evaneidt/Camera-Dev/README.md

# Camera-Dev
Repo for camera dev board schematics, CAD, and code.
