evaneidt/Camera-Dev/Drawings/I2S Clock Diagram.png

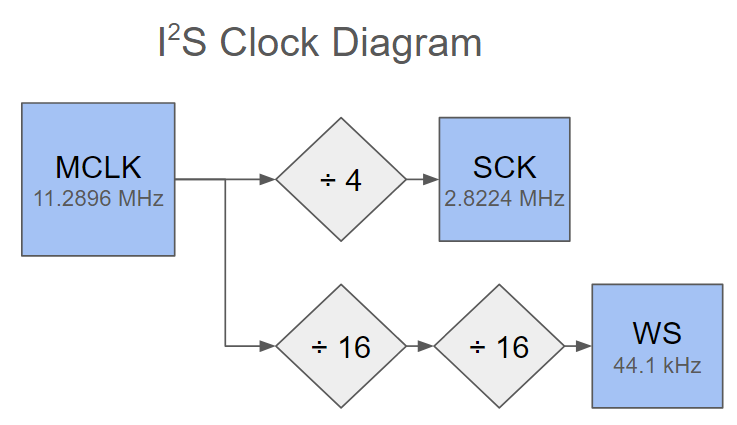
Drawings/I2S Clock Diagram.png
