evaneidt/Camera-Dev/Sims/Draft1.asc

C1: cap; 1000p
C2: cap; 3900p
C3: cap; 10µ
R1: res; 5.1k
R2: res; 2.2k
R3: res; 4.7k
R4: res; 1000
U1: opamp
V1: voltage; 2.5
V2: voltage; ""; AC 1.95
Named nets: 0, OUT, FB, IN
.ac dec 100 0.1 100k
.lib opamp.sub
