evaneidt/Camera-Dev/Sims/PoR.asc

A1: diffschmitt
C1: cap; 1µ
R1: res; 100k
R2: res; 5k
R3: res; 10k
V1: voltage; PULSE(0 3.3 100m 1n 0 10)
Named nets: 0, Out, V1
.tran 1
