evaneidt/Camera-Dev/(list of files, drawings)

Other design files:
Schematics/Camera/freerouting.dsn
Schematics/Camera/temp-freerouting.dsn
