evaneidt/Camera-Dev/Schematics/Camera/Camera.kicad_pcb

## KiCad design Schematics/Camera/Camera.kicad_pcb (2024-11-17)

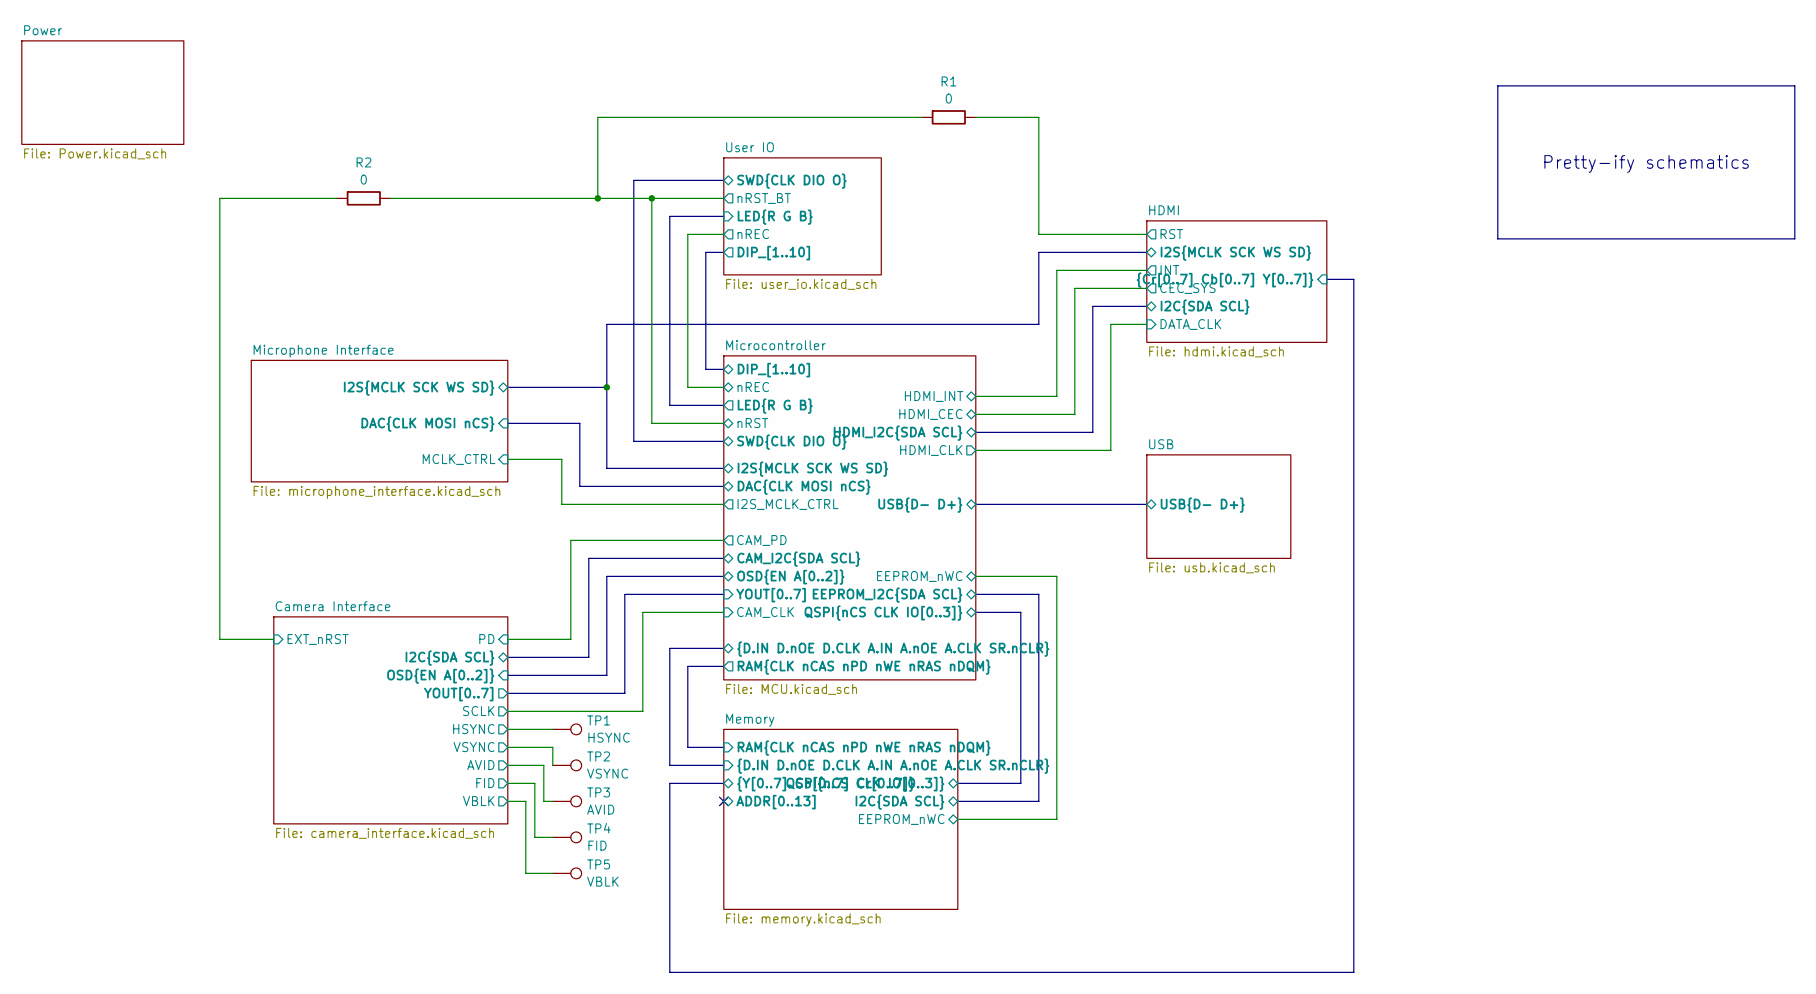
[picture p2: schematic Camera.kicad_sch, Camera Testing Board]

Parts:
R1, R2: 0; R_0603_1608Metric
TP1: HSYNC; TestPoint_Keystone_5000-5004_Miniature
TP2: VSYNC; TestPoint_Keystone_5000-5004_Miniature
TP3: AVID; TestPoint_Keystone_5000-5004_Miniature
TP4: FID; TestPoint_Keystone_5000-5004_Miniature
TP5: VBLK; TestPoint_Keystone_5000-5004_Miniature

Connections:
/Camera Interface/AVID: TP3.1; also elsewhere on the board
/Camera Interface/EXT_nRST: R2.1; also elsewhere on the board
/Camera Interface/FID: TP4.1; also elsewhere on the board
/Camera Interface/HSYNC: TP1.1; also elsewhere on the board
/Camera Interface/VBLK: TP5.1; also elsewhere on the board
/Camera Interface/VSYNC: TP2.1; also elsewhere on the board
/HDMI/RST: R1.2; also elsewhere on the board
/User IO/nRST_BT: R1.1, R2.2; also elsewhere on the board

Notes on the sheet:
Pretty-ify schematics

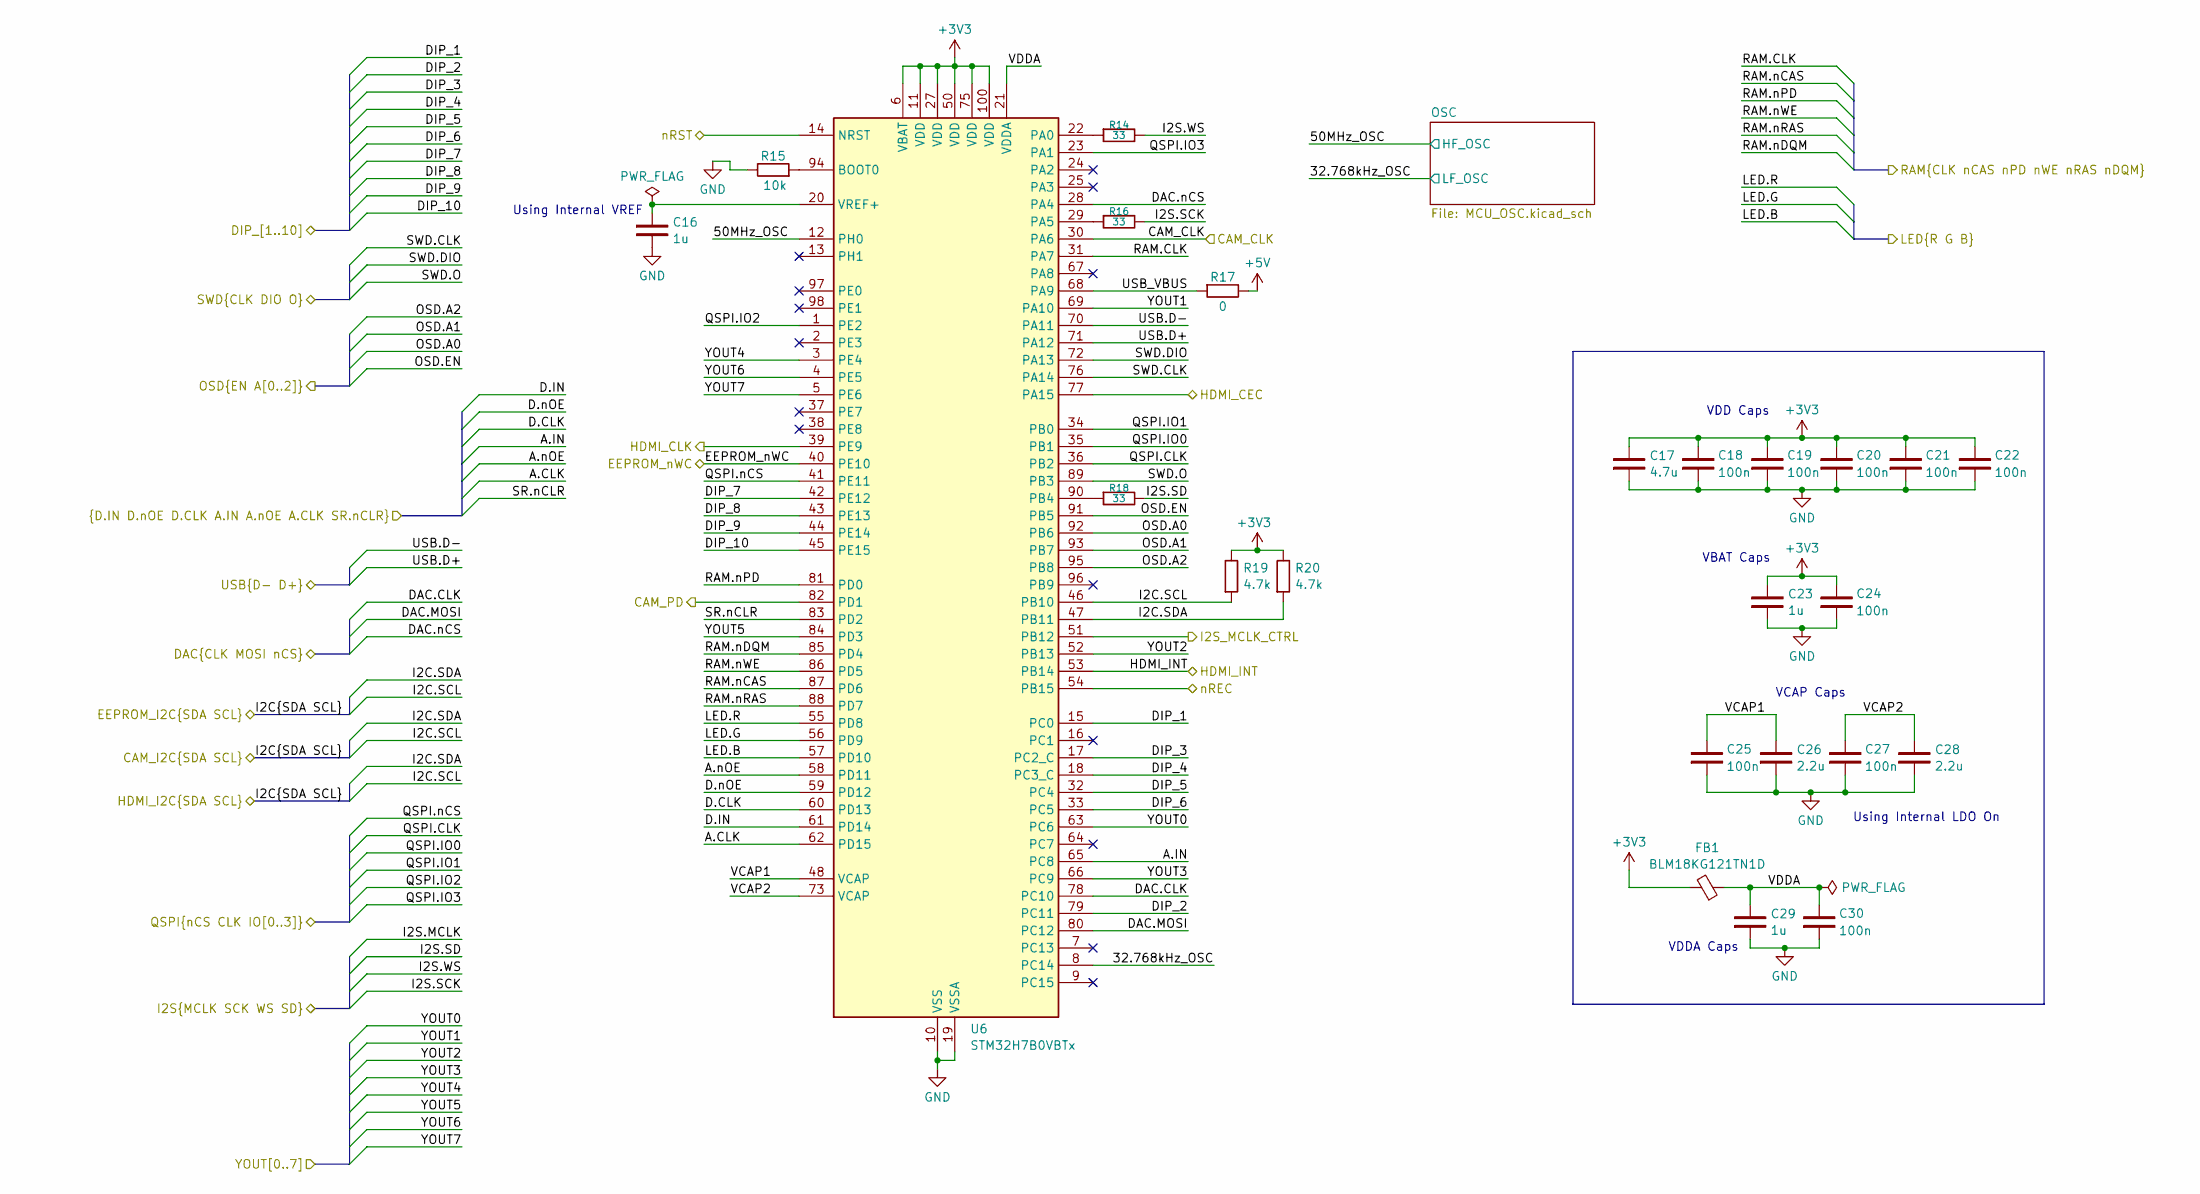
[picture p3: schematic MCU.kicad_sch, Camera Testing Board]

Parts:
C16, C23, C29: 1u; C_0603_1608Metric
C17: 4.7u; C_0603_1608Metric
C18, C19, C20, C21, C22, C24, C25, C27, C30: 100n; C_0603_1608Metric
C26, C28: 2.2u; C_0603_1608Metric
FB1: BLM18KG121TN1D; L_0603_1608Metric
R14, R16, R18: 33; R_0402_1005Metric
R15: 10k; R_0603_1608Metric
R17: 0; R_0603_1608Metric
R19, R20: 4.7k; R_0603_1608Metric
U6: STM32H7B0VBTx; LQFP-100_14x14mm_P0.5mm

Connections:
+3V3: C17.2, C18.2, C19.2, C20.2, C21.2, C22.2, C23.2, C24.2, FB1.2, R19.2, R20.2, U6.6 (VBAT), U6.11 (VDD), U6.27 (VDD), U6.50 (VDD), U6.75 (VDD), U6.100 (VDD); also elsewhere on the board
+5V: R17.2; also elsewhere on the board
/Camera Interface/OSD.A0: U6.92 (PB6); also elsewhere on the board
/Camera Interface/OSD.A1: U6.93 (PB7); also elsewhere on the board
/Camera Interface/OSD.A2: U6.95 (PB8); also elsewhere on the board
/Camera Interface/OSD.EN: U6.91 (PB5); also elsewhere on the board
/Camera Interface/PD: U6.82 (PD1); also elsewhere on the board
/Camera Interface/SCLK: U6.30 (PA6); also elsewhere on the board
/Camera Interface/YOUT0: U6.63 (PC6); also elsewhere on the board
/Camera Interface/YOUT1: U6.69 (PA10); also elsewhere on the board
/Camera Interface/YOUT2: U6.52 (PB13); also elsewhere on the board
/Camera Interface/YOUT3: U6.66 (PC9); also elsewhere on the board
/Camera Interface/YOUT4: U6.3 (PE4); also elsewhere on the board
/Camera Interface/YOUT5: U6.84 (PD3); also elsewhere on the board
/Camera Interface/YOUT6: U6.4 (PE5); also elsewhere on the board
/Camera Interface/YOUT7: U6.5 (PE6); also elsewhere on the board
/HDMI/CEC_SYS: U6.77 (PA15); also elsewhere on the board
/HDMI/DATA_CLK: U6.39 (PE9); also elsewhere on the board
/HDMI/I2C.SCL: R19.1, U6.46 (PB10); also elsewhere on the board
/HDMI/I2C.SDA: R20.1, U6.47 (PB11); also elsewhere on the board
/HDMI/I2S.SCK: R16.2; also elsewhere on the board
/HDMI/I2S.SD: R18.2; also elsewhere on the board
/HDMI/I2S.WS: R14.2; also elsewhere on the board
/HDMI/INT: U6.53 (PB14); also elsewhere on the board
/Memory/A.CLK: U6.62 (PD15); also elsewhere on the board
/Memory/A.IN: U6.65 (PC8); also elsewhere on the board
/Memory/A.nOE: U6.58 (PD11); also elsewhere on the board
/Memory/D.CLK: U6.60 (PD13); also elsewhere on the board
/Memory/D.IN: U6.61 (PD14); also elsewhere on the board
/Memory/D.nOE: U6.59 (PD12); also elsewhere on the board
/Memory/EEPROM_nWC: U6.40 (PE10); also elsewhere on the board
/Memory/QSPI.CLK: U6.36 (PB2); also elsewhere on the board
/Memory/QSPI.IO0: U6.35 (PB1); also elsewhere on the board
/Memory/QSPI.IO1: U6.34 (PB0); also elsewhere on the board
/Memory/QSPI.IO2: U6.1 (PE2); also elsewhere on the board
/Memory/QSPI.IO3: U6.23 (PA1); also elsewhere on the board
/Memory/QSPI.nCS: U6.41 (PE11); also elsewhere on the board
/Memory/RAM.CLK: U6.31 (PA7); also elsewhere on the board
/Memory/RAM.nCAS: U6.87 (PD6); also elsewhere on the board
/Memory/RAM.nDQM: U6.85 (PD4); also elsewhere on the board
/Memory/RAM.nPD: U6.81 (PD0); also elsewhere on the board
/Memory/RAM.nRAS: U6.88 (PD7); also elsewhere on the board
/Memory/RAM.nWE: U6.86 (PD5); also elsewhere on the board
/Memory/SR.nCLR: U6.83 (PD2); also elsewhere on the board
/Microcontroller/32.768kHz_OSC: U6.8 (PC14); also elsewhere on the board
/Microcontroller/50MHz_OSC: U6.12 (PH0); also elsewhere on the board
/Microcontroller/DAC.CLK: U6.78 (PC10); also elsewhere on the board
/Microcontroller/DAC.MOSI: U6.80 (PC12); also elsewhere on the board
/Microcontroller/DAC.nCS: U6.28 (PA4); also elsewhere on the board
/Microcontroller/DIP_1: U6.15 (PC0)
/Microcontroller/DIP_2: U6.79 (PC11)
/Microcontroller/DIP_3: U6.17 (PC2_C)
/Microcontroller/DIP_4: U6.18 (PC3_C)
/Microcontroller/DIP_5: U6.32 (PC4)
/Microcontroller/DIP_6: U6.33 (PC5)
/Microcontroller/DIP_7: U6.42 (PE12)
/Microcontroller/DIP_8: U6.43 (PE13)
/Microcontroller/DIP_9: U6.44 (PE14)
/Microcontroller/DIP_10: U6.45 (PE15)
/Microcontroller/LED.B: U6.57 (PD10); also elsewhere on the board
/Microcontroller/LED.G: U6.56 (PD9); also elsewhere on the board
/Microcontroller/LED.R: U6.55 (PD8); also elsewhere on the board
/Microcontroller/SWD.CLK: U6.76 (PA14); also elsewhere on the board
/Microcontroller/SWD.DIO: U6.72 (PA13); also elsewhere on the board
/Microcontroller/SWD.O: U6.89 (PB3); also elsewhere on the board
/Microcontroller/USB.D+: U6.71 (PA12); also elsewhere on the board
/Microcontroller/USB.D-: U6.70 (PA11); also elsewhere on the board
/Microcontroller/USB_VBUS: R17.1, U6.68 (PA9)
/Microcontroller/VCAP1: C25.2, C26.2, U6.48 (VCAP)
/Microcontroller/VCAP2: C27.2, C28.2, U6.73 (VCAP)
/Microcontroller/VDDA: C29.2, C30.2, FB1.1, U6.21 (VDDA)
/Microcontroller/nREC: U6.54 (PB15); also elsewhere on the board
/Microphone Interface/Microphone Clocks/CTRL: U6.51 (PB12); also elsewhere on the board
/User IO/nRST_BT: U6.14 (NRST); also elsewhere on the board
GND: C16.1, C17.1, C18.1, C19.1, C20.1, C21.1, C22.1, C23.1, C24.1, C25.1, C26.1, C27.1, C28.1, C29.1, C30.1, R15.2, U6.10 (VSS), U6.19 (VSSA), U6.26 (VSS), U6.49 (VSS), U6.74 (VSS), U6.99 (VSS); also elsewhere on the board
unnamed: R15.1, U6.94 (BOOT0)
unnamed: R14.1, U6.22 (PA0)
unnamed: R16.1, U6.29 (PA5)
unnamed: R18.1, U6.90 (PB4)
unnamed: C16.2, U6.20 (VREF+)

Notes on the sheet:
Using Internal LDO On
VDDA Caps
Using Internal VREF
VBAT Caps
VCAP Caps
VDD Caps

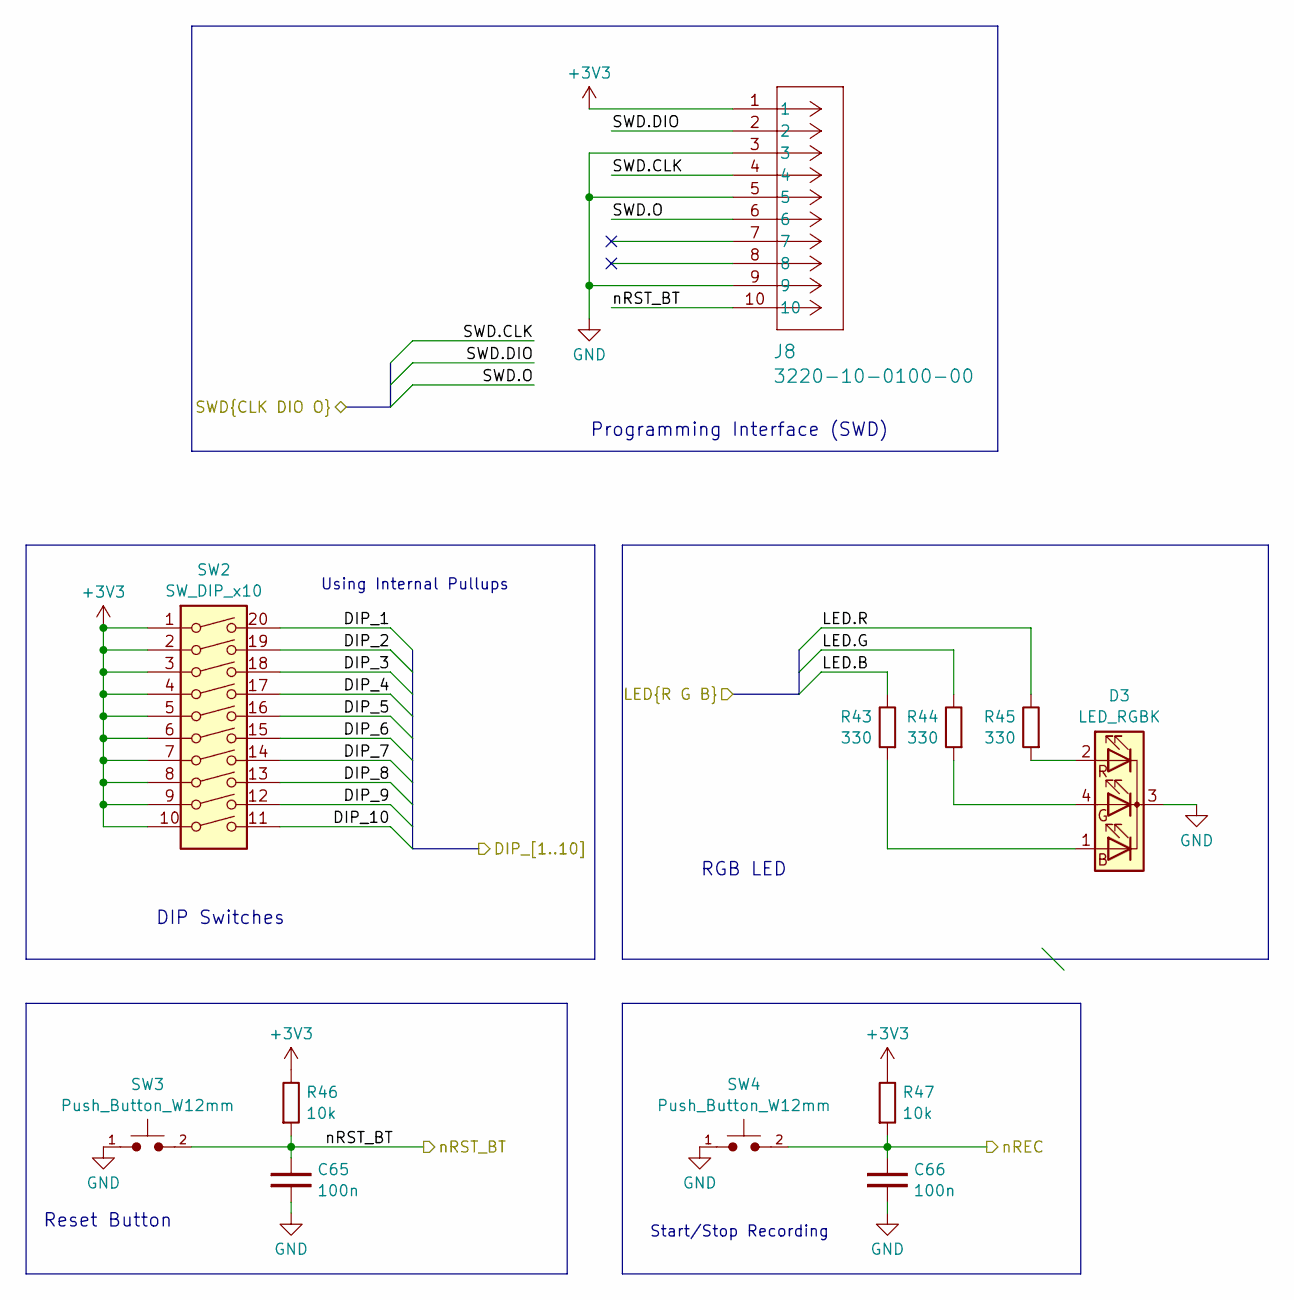
[picture p4: schematic user_io.kicad_sch, Camera Testing Board]

Parts:
C65, C66: 100n; C_0603_1608Metric
D3: LED_RGBK; LED_D5.0mm-4_RGB
J8: 3220-10-0100-00; CONN_3220-10-0100-00_CNC
R43, R44, R45: 330; R_0603_1608Metric
R46, R47: 10k; R_0603_1608Metric
SW2: SW_DIP_x10; DIP-20_W7.62mm
SW3, SW4: Push_Button_W12mm; SW_Push_1P1T_NO_CK_KSC7xxJ

Connections:
+3V3: J8.1, R46.2, R47.2, SW2.1, SW2.2, SW2.3, SW2.4, SW2.5, SW2.6, SW2.7, SW2.8, SW2.9, SW2.10; also elsewhere on the board
/Microcontroller/LED.B: R43.2; also elsewhere on the board
/Microcontroller/LED.G: R44.2; also elsewhere on the board
/Microcontroller/LED.R: R45.2; also elsewhere on the board
/Microcontroller/SWD.CLK: J8.4; also elsewhere on the board
/Microcontroller/SWD.DIO: J8.2; also elsewhere on the board
/Microcontroller/SWD.O: J8.6; also elsewhere on the board
/Microcontroller/nREC: C66.2, R47.1, SW4.2; also elsewhere on the board
/User IO/nRST_BT: C65.2, J8.10, R46.1, SW3.2; also elsewhere on the board
GND: C65.1, C66.1, D3.3 (K), J8.3, J8.5, J8.9, SW3.1, SW4.1; also elsewhere on the board
unnamed: D3.1 (BA), R43.1
unnamed: D3.4 (GA), R44.1
unnamed: D3.2 (RA), R45.1

Notes on the sheet:
Using Internal Pullups
DIP Switches
Programming Interface (SWD)
Start/Stop Recording
Reset Button
RGB LED

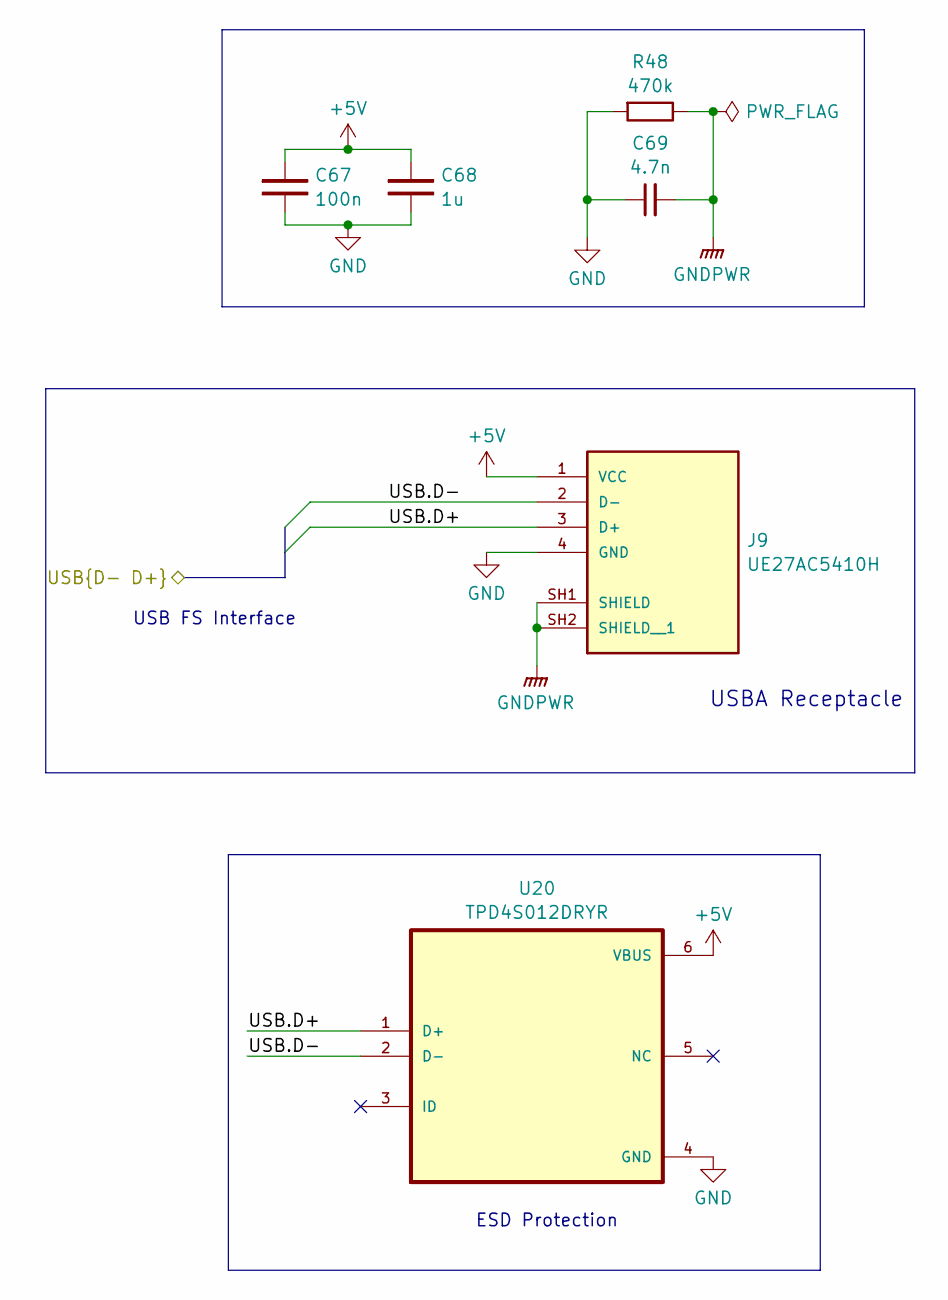
[picture p5: schematic usb.kicad_sch, Camera Testing Board]

Parts:
C67: 100n; C_0603_1608Metric
C68: 1u; C_0603_1608Metric
C69: 4.7n; C_0603_1608Metric
J9: UE27AC5410H; AMPHENOL_UE27AC5410H; PARTREV G
R48: 470k; R_0603_1608Metric
U20: TPD4S012DRYR; PSON50P145X100X60-6N

Connections:
+5V: C67.2, C68.2, J9.1 (VCC), U20.6 (VBUS); also elsewhere on the board
/Microcontroller/USB.D+: J9.3 (D+), U20.1 (D+); also elsewhere on the board
/Microcontroller/USB.D-: J9.2 (D-), U20.2 (D-); also elsewhere on the board
GND: C67.1, C68.1, C69.1, J9.4 (GND), R48.1, U20.4 (GND); also elsewhere on the board
GNDPWR: C69.2, J9.SH1 (SHIELD), J9.SH2 (SHIELD__1), R48.2; also elsewhere on the board

Notes on the sheet:
USB FS Interface
ESD Protection
USBA Receptacle

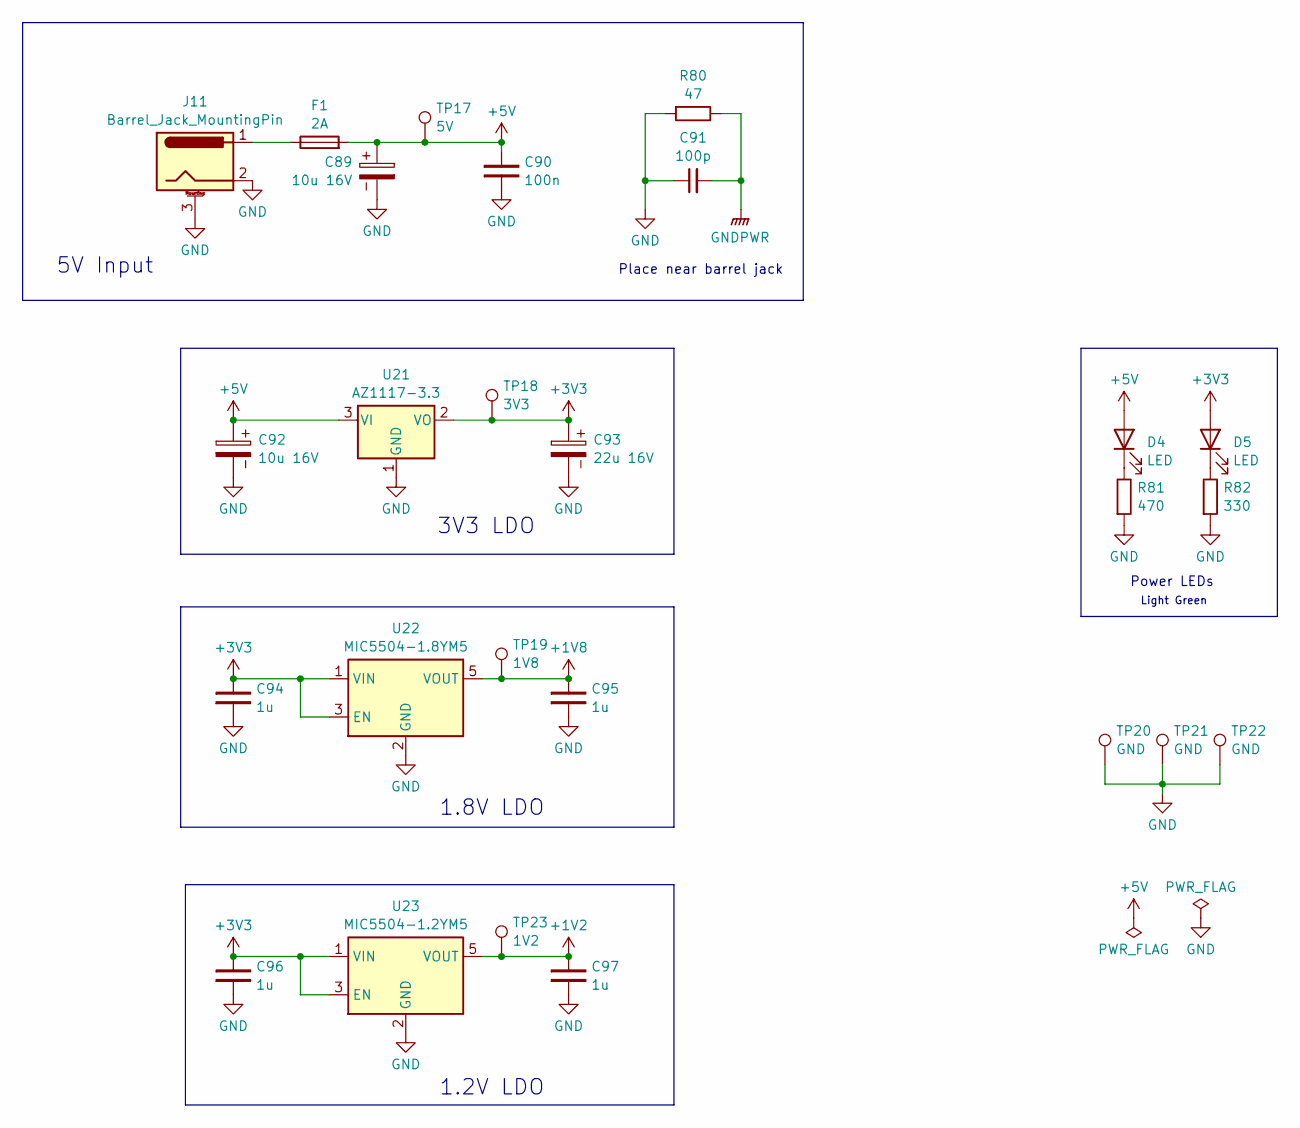
[picture p6: schematic Power.kicad_sch, Camera Testing Board]

Parts:
C89, C92: 10u 16V; CP_EIA-3216-18_Kemet-A
C90: 100n; C_0603_1608Metric
C91: 100p; C_0402_1005Metric
C93: 22u 16V; CP_EIA-3528-21_Kemet-B
C94, C95, C96, C97: 1u; C_0603_1608Metric
D4, D5: LED; LED_0603_1608Metric
F1: 2A; Fuse_0603_1608Metric_Pad1.05x0.95mm_HandSolder
J11: Barrel_Jack_MountingPin; BarrelJack_CUI_PJ-036AH-SMT_Horizontal
R80: 47; R_0603_1608Metric
R81: 470; R_0603_1608Metric
R82: 330; R_0603_1608Metric
TP17: 5V; TestPoint_Keystone_5000-5004_Miniature
TP18: 3V3; TestPoint_Keystone_5000-5004_Miniature
TP19: 1V8; TestPoint_Keystone_5000-5004_Miniature
TP20, TP21, TP22: GND; TestPoint_Keystone_5010-5014_Multipurpose
TP23: 1V2; TestPoint_Keystone_5000-5004_Miniature
U21: AZ1117-3.3; SOT-223-3_TabPin2
U22: MIC5504-1.8YM5; SOT-23-5
U23: MIC5504-1.2YM5; SOT-23-5

Connections:
+1V2: C97.2, TP23.1, U23.5 (VOUT); also elsewhere on the board
+1V8: C95.2, TP19.1, U22.5 (VOUT); also elsewhere on the board
+3V3: C93.1, C94.2, C96.2, D5.2 (A), TP18.1, U21.2 (VO), U22.1 (VIN), U22.3 (EN), U23.1 (VIN), U23.3 (EN); also elsewhere on the board
+5V: C89.1, C90.2, C92.1, D4.2 (A), F1.2, TP17.1, U21.3 (VI); also elsewhere on the board
GND: C89.2, C90.1, C91.1, C92.2, C93.2, C94.1, C95.1, C96.1, C97.1, J11.2, J11.3 (MountPin), R80.1, R81.1, R82.1, TP20.1, TP21.1, TP22.1, U21.1 (GND), U22.2 (GND), U23.2 (GND); also elsewhere on the board
GNDPWR: C91.2, R80.2; also elsewhere on the board
unnamed: D4.1 (K), R81.2
unnamed: D5.1 (K), R82.2
unnamed: F1.1, J11.1

Notes on the sheet:
Place near barrel jack
1.8V LDO
1.2V LDO
Power LEDs
3V3 LDO
Light Green
5V Input

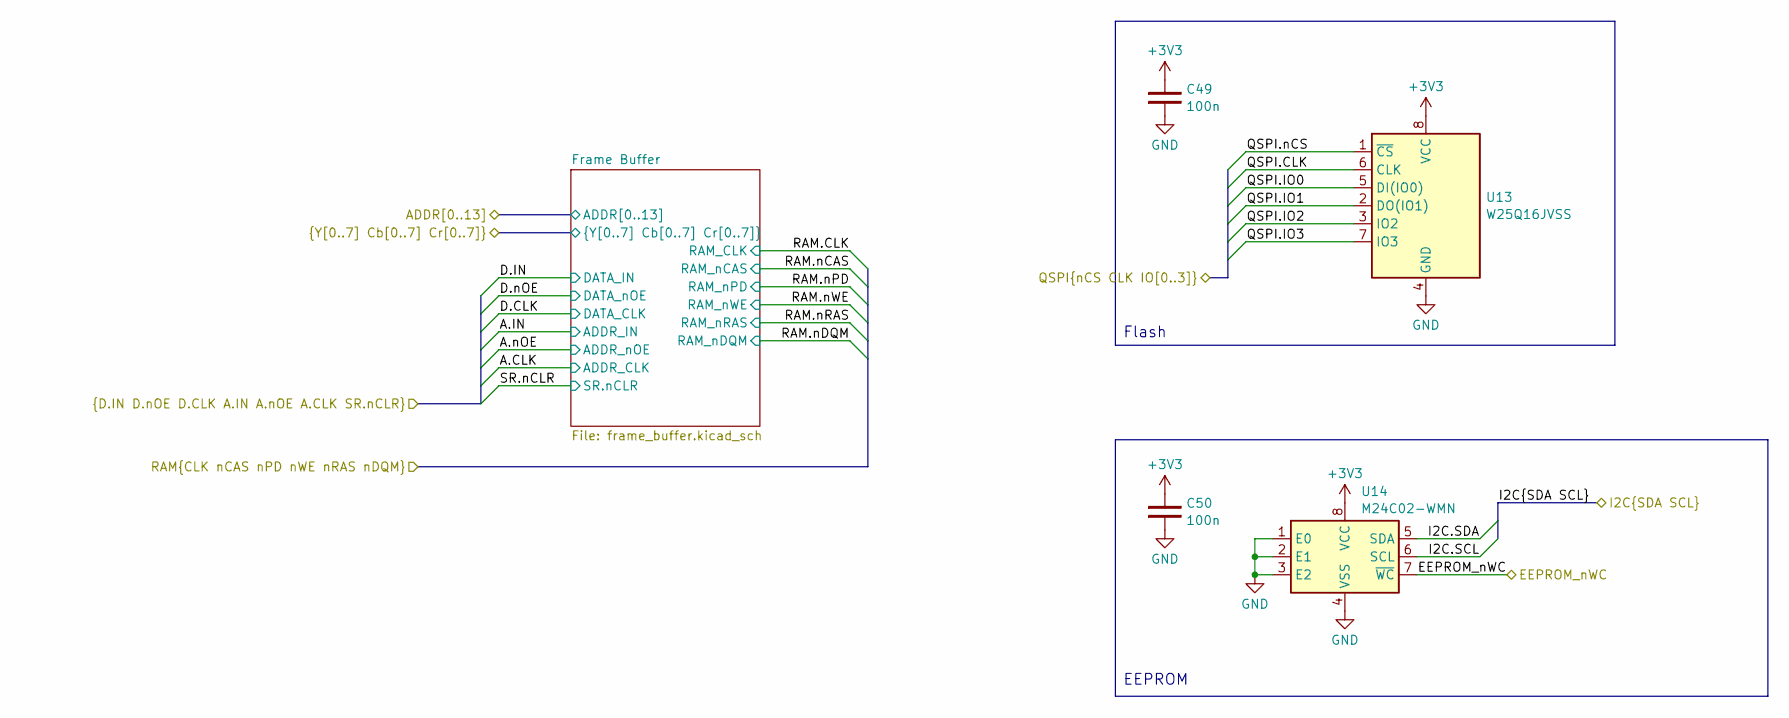
[picture p7: schematic memory.kicad_sch, Camera Testing Board]

Parts:
C49, C50: 100n; C_0603_1608Metric
U13: W25Q16JVSS; SOIC-8_5.23x5.23mm_P1.27mm
U14: M24C02-WMN; SOIC-8_3.9x4.9mm_P1.27mm

Connections:
+3V3: C49.2, C50.2, U13.8 (VCC), U14.8 (VCC); also elsewhere on the board
/HDMI/I2C.SCL: U14.6 (SCL); also elsewhere on the board
/HDMI/I2C.SDA: U14.5 (SDA); also elsewhere on the board
/Memory/EEPROM_nWC: U14.7 (~WC); also elsewhere on the board
/Memory/QSPI.CLK: U13.6 (CLK); also elsewhere on the board
/Memory/QSPI.IO0: U13.5 (DI(IO0)); also elsewhere on the board
/Memory/QSPI.IO1: U13.2 (DO(IO1)); also elsewhere on the board
/Memory/QSPI.IO2: U13.3 (IO2); also elsewhere on the board
/Memory/QSPI.IO3: U13.7 (IO3); also elsewhere on the board
/Memory/QSPI.nCS: U13.1 (~CS); also elsewhere on the board
GND: C49.1, C50.1, U13.4 (GND), U14.1 (E0), U14.2 (E1), U14.3 (E2), U14.4 (VSS); also elsewhere on the board

Notes on the sheet:
Flash
EEPROM

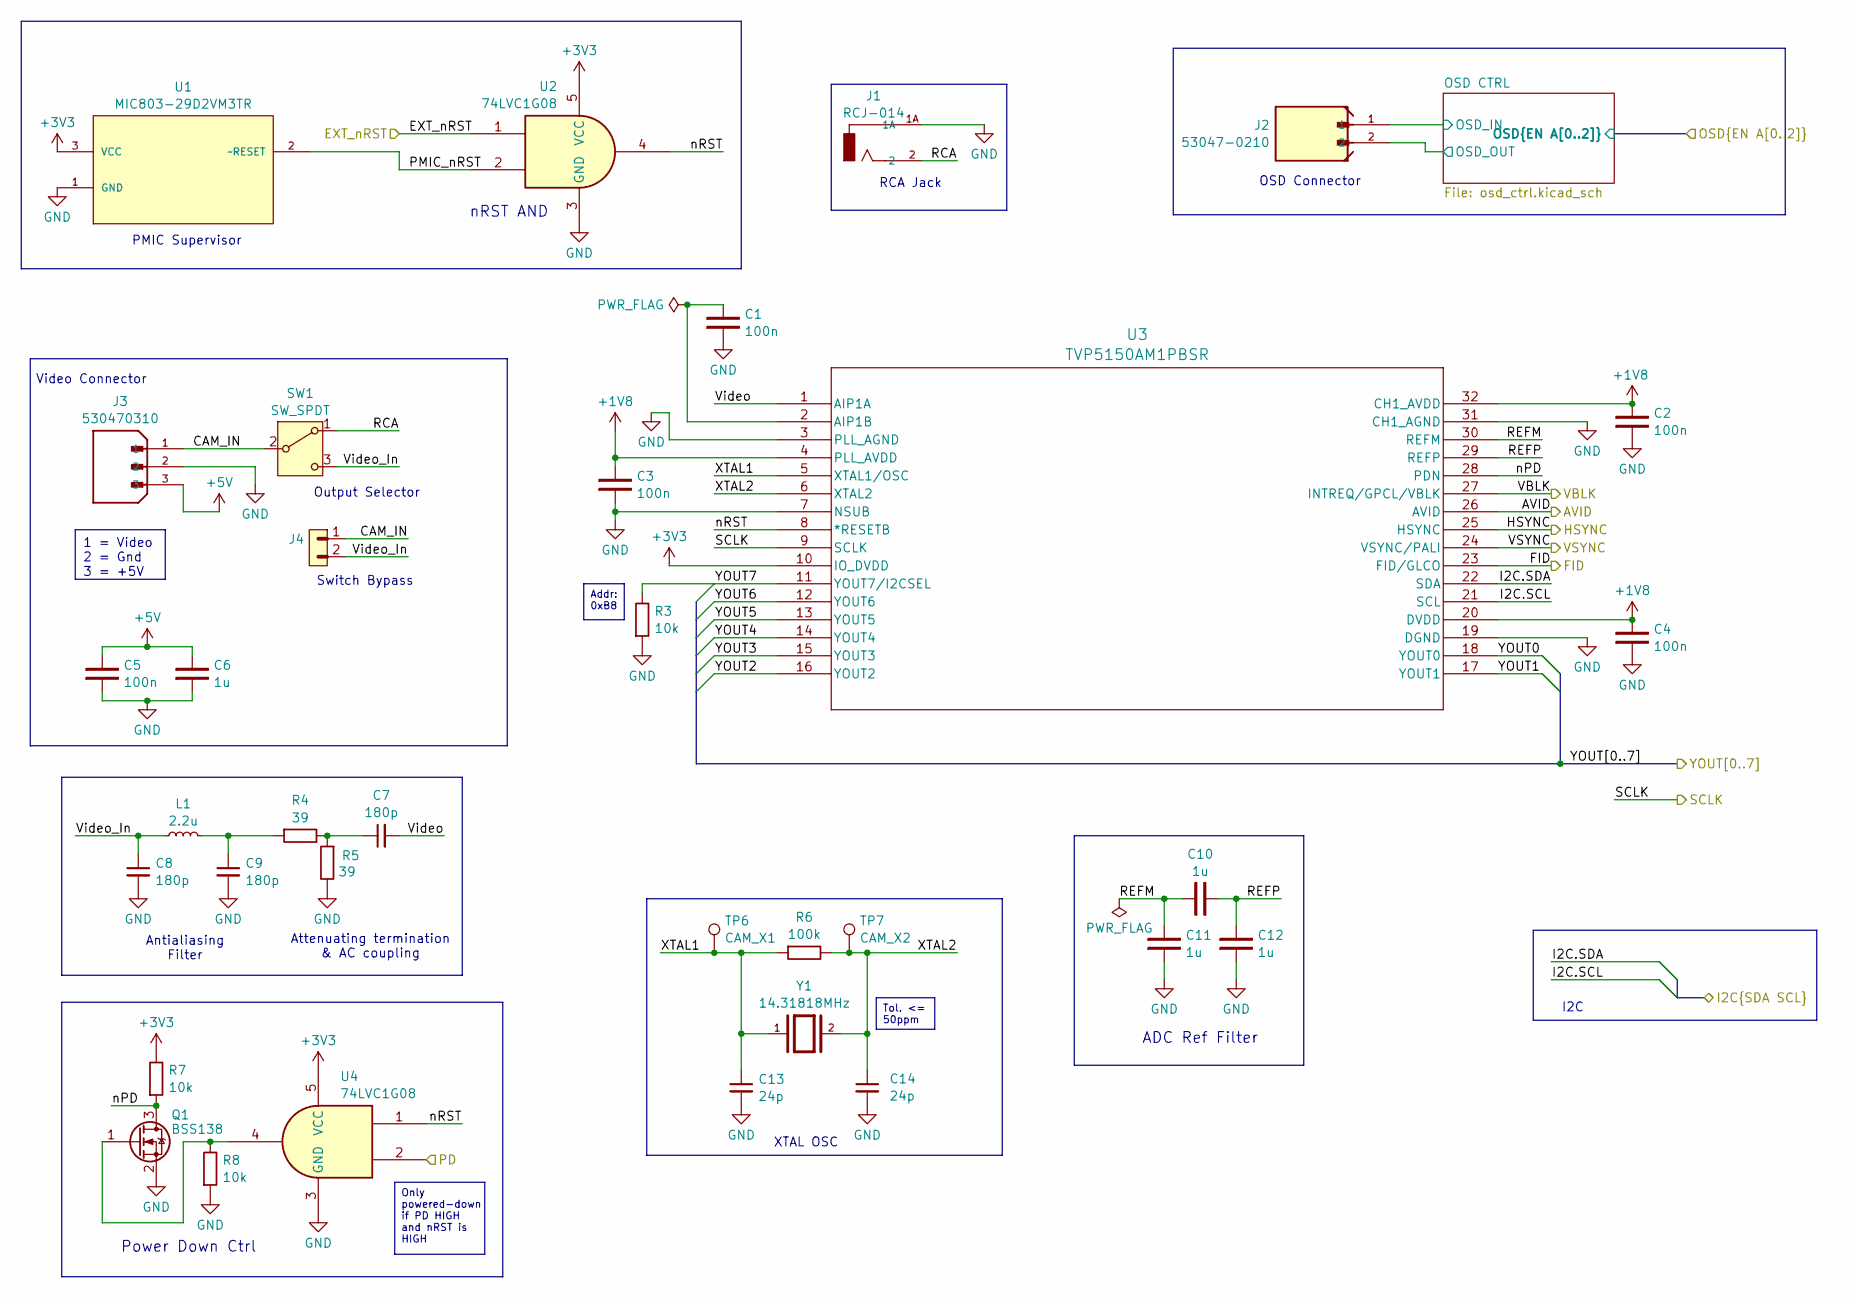
[picture p8: schematic camera_interface.kicad_sch, Camera Testing Board]

Parts:
C1, C2, C3, C4, C5: 100n; C_0603_1608Metric
C6, C10, C11, C12: 1u; C_0603_1608Metric
C7, C8, C9: 180p; C_0402_1005Metric
C13, C14: 24p; C_0402_1005Metric
J1: RCJ-014; CUI_RCJ-014; PART_REV B
J2: 53047-0210; Molex_PicoBlade_53047-0210_1x02_P1.25mm_Vertical; PARTREV 04/19/2022
J3: 530470310; MOLEX_530470310; PARTREV A
J4: PINHD_1x2_Male; PinHeader_1x02_P2.54mm_Vertical
L1: 2.2u; L_1008_2520Metric
Q1: BSS138; SOT-23
R3, R7, R8: 10k; R_0603_1608Metric
R4, R5: 39; R_0603_1608Metric
R6: 100k; R_0603_1608Metric
SW1: SW_SPDT; SW_Slide_SPDT_Straight_CK_OS102011MS2Q
TP6: CAM_X1; TestPoint_Keystone_5000-5004_Miniature
TP7: CAM_X2; TestPoint_Keystone_5000-5004_Miniature
U1: MIC803-29D2VM3TR; SOT95P232X110-3N; MPN MIC803-29D2VM3TR
U2, U4: 74LVC1G08; SOT-23-5
U3: TVP5150AM1PBSR; PBS32
Y1: 14.31818MHz; XTAL_ABLS2-14.31818MHZ-D4Y-T; PARTREV 11.15.2016

Connections:
+1V8: C2.2, C3.2, C4.2, U3.4 (PLL_AVDD), U3.20 (DVDD), U3.32 (CH1_AVDD); also elsewhere on the board
+3V3: R7.2, U1.3 (VCC), U2.5 (VCC), U3.10 (IO_DVDD), U4.5 (VCC); also elsewhere on the board
+5V: C5.2, C6.2, J3.3; also elsewhere on the board
/Camera Interface/AVID: U3.26 (AVID); also elsewhere on the board
/Camera Interface/CAM_IN: J3.1, J4.1, SW1.2 (B)
/Camera Interface/EXT_nRST: U2.1; also elsewhere on the board
/Camera Interface/FID: U3.23 (FID/GLCO); also elsewhere on the board
/Camera Interface/HSYNC: U3.25 (HSYNC); also elsewhere on the board
/Camera Interface/OSD CTRL/OSD_IN: J2.1; also elsewhere on the board
/Camera Interface/OSD CTRL/OSD_OUT: J2.2; also elsewhere on the board
/Camera Interface/PD: U4.2; also elsewhere on the board
/Camera Interface/PMIC_nRST: U1.2 (~RESET), U2.2
/Camera Interface/RCA: J1.2, SW1.1 (A)
/Camera Interface/REFM: C10.2, C11.2, U3.30 (REFM)
/Camera Interface/REFP: C10.1, C12.2, U3.29 (REFP)
/Camera Interface/SCLK: U3.9 (SCLK); also elsewhere on the board
/Camera Interface/VBLK: U3.27 (INTREQ/GPCL/VBLK); also elsewhere on the board
/Camera Interface/VSYNC: U3.24 (VSYNC/PALI); also elsewhere on the board
/Camera Interface/Video: C7.2, U3.1 (AIP1A)
/Camera Interface/Video_In: C8.1, J4.2, L1.1, SW1.3 (C)
/Camera Interface/XTAL1: C13.1, R6.1, TP6.1, U3.5 (XTAL1/OSC), Y1.1
/Camera Interface/XTAL2: C14.1, R6.2, TP7.1, U3.6 (XTAL2), Y1.2
/Camera Interface/YOUT0: U3.18 (YOUT0); also elsewhere on the board
/Camera Interface/YOUT1: U3.17 (YOUT1); also elsewhere on the board
/Camera Interface/YOUT2: U3.16 (YOUT2); also elsewhere on the board
/Camera Interface/YOUT3: U3.15 (YOUT3); also elsewhere on the board
/Camera Interface/YOUT4: U3.14 (YOUT4); also elsewhere on the board
/Camera Interface/YOUT5: U3.13 (YOUT5); also elsewhere on the board
/Camera Interface/YOUT6: U3.12 (YOUT6); also elsewhere on the board
/Camera Interface/YOUT7: R3.2, U3.11 (YOUT7/I2CSEL); also elsewhere on the board
/Camera Interface/nPD: Q1.3 (D), R7.1, U3.28 (PDN)
/Camera Interface/nRST: U2.4, U3.8 (*RESETB), U4.1
/HDMI/I2C.SCL: U3.21 (SCL); also elsewhere on the board
/HDMI/I2C.SDA: U3.22 (SDA); also elsewhere on the board
GND: C1.1, C2.1, C3.1, C4.1, C5.1, C6.1, C8.2, C9.2, C11.1, C12.1, C13.2, C14.2, J1.1A, J3.2, Q1.2 (S), R3.1, R5.2, R8.1, U1.1 (GND), U2.3 (GND), U3.3 (PLL_AGND), U3.7 (NSUB), U3.19 (DGND), U3.31 (CH1_AGND), U4.3 (GND); also elsewhere on the board
unnamed: C7.1, R4.2, R5.1
unnamed: C9.1, L1.2, R4.1
unnamed: Q1.1 (G), R8.2, U4.4
unnamed: C1.2, U3.2 (AIP1B)

Notes on the sheet:
Addr: 0xB8
Only powered-down if PD HIGH and nRST is HIGH
Tol. <= 50ppm
1 = Video 2 = Gnd 3 = +5V
I2C
Switch Bypass
PMIC Supervisor
Power Down Ctrl
Attenuating termination & AC coupling
XTAL OSC
OSD Connector
nRST AND
Video Connector
Antialiasing Filter
ADC Ref Filter
RCA Jack
Output Selector
