evaneidt/Camera-Dev/Schematics/Camera/Camera.kicad_pcb

## KiCad design Schematics/Camera/Camera.kicad_pcb (continued)

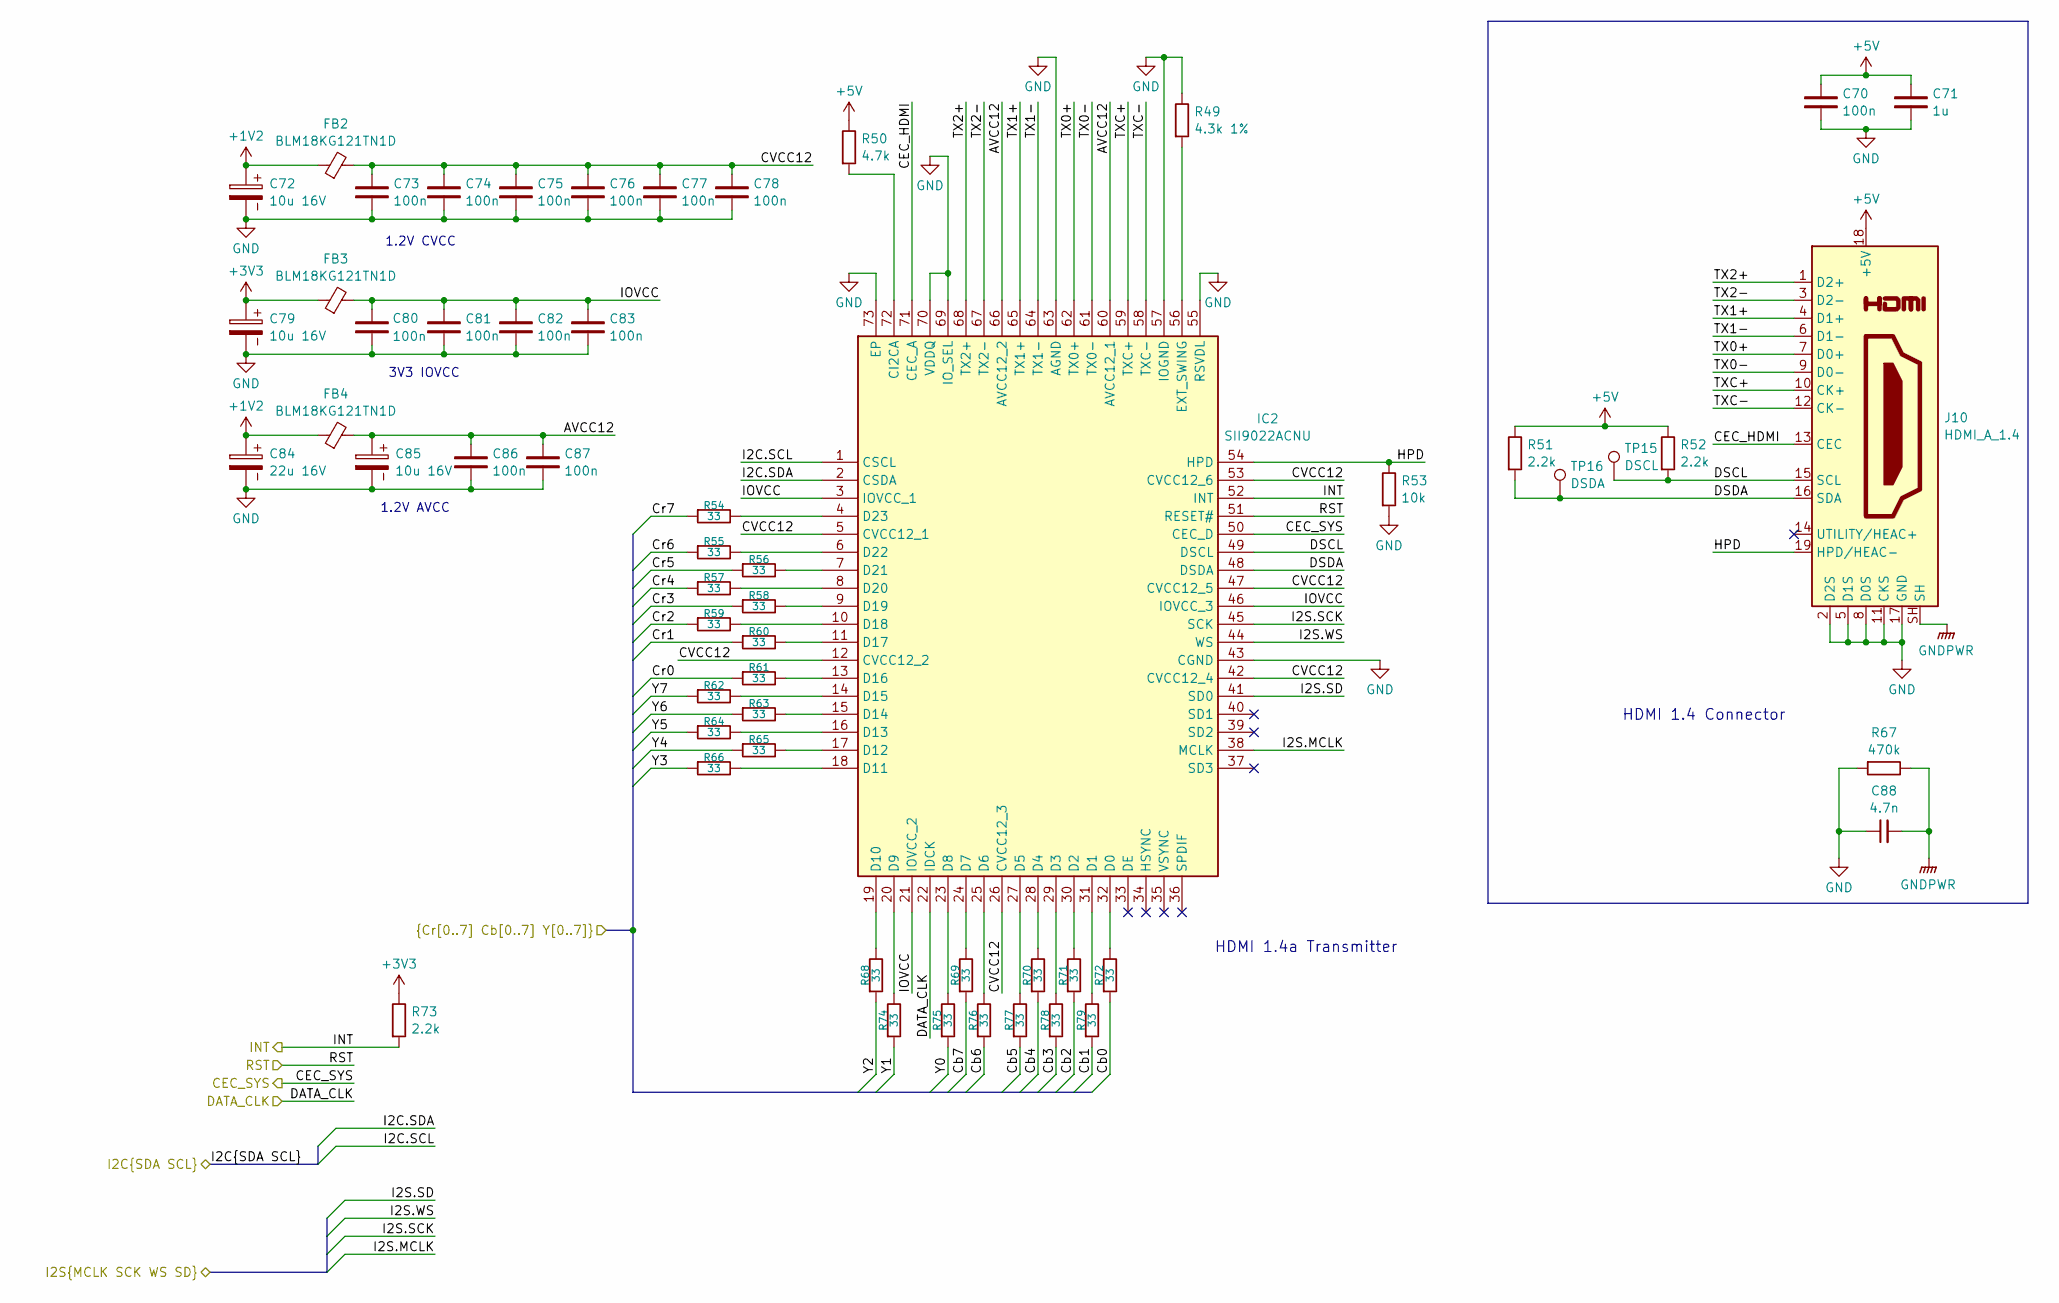
[picture p9: schematic hdmi.kicad_sch, Camera Testing Board]

Parts:
C70: 100n; C_0603_1608Metric
C71: 1u; C_0603_1608Metric
C72, C79, C85: 10u 16V; CP_EIA-3216-18_Kemet-A
C73, C74, C75, C76, C77, C78, C80, C81, C82, C83, C86, C87: 100n; C_0402_1005Metric
C84: 22u 16V; CP_EIA-3528-21_Kemet-B
C88: 4.7n; C_0603_1608Metric
FB2, FB3, FB4: BLM18KG121TN1D; L_0603_1608Metric
IC2: SII9022ACNU; QFN50P1000X1000X90-73N-D; Manufacturer_Part_Number SII9022ACNU
J10: HDMI_A_1.4; AMPHENOL_10029449-111RLF
R49: 4.3k 1%; R_0603_1608Metric
R50: 4.7k; R_0603_1608Metric
R51, R52, R73: 2.2k; R_0603_1608Metric
R53: 10k; R_0603_1608Metric
R54, R55, R56, R57, R58, R59, R60, R61, R62, R63, R64, R65, R66, R68, R69, R70, R71, R72, R74, R75, R76, R77, R78, R79: 33; R_0201_0603Metric
R67: 470k; R_0603_1608Metric
TP15: DSCL; TestPoint_Keystone_5000-5004_Miniature
TP16: DSDA; TestPoint_Keystone_5000-5004_Miniature

Connections:
+1V2: C72.1, C84.1, FB2.1, FB4.1; also elsewhere on the board
+3V3: C79.1, FB3.1, R73.2; also elsewhere on the board
+5V: C70.2, C71.2, J10.18 (+5V), R50.2, R51.2, R52.2; also elsewhere on the board
/HDMI/AVCC12: C85.1, C86.2, C87.2, FB4.2, IC2.60 (AVCC12_1), IC2.66 (AVCC12_2)
/HDMI/CEC_HDMI: IC2.71 (CEC_A), J10.13 (CEC)
/HDMI/CEC_SYS: IC2.50 (CEC_D); also elsewhere on the board
/HDMI/CVCC12: C73.2, C74.2, C75.2, C76.2, C77.2, C78.2, FB2.2, IC2.5 (CVCC12_1), IC2.12 (CVCC12_2), IC2.26 (CVCC12_3), IC2.42 (CVCC12_4), IC2.47 (CVCC12_5), IC2.53 (CVCC12_6)
/HDMI/Cb0: R72.1; also elsewhere on the board
/HDMI/Cb1: R79.1; also elsewhere on the board
/HDMI/Cb2: R71.1; also elsewhere on the board
/HDMI/Cb3: R78.1; also elsewhere on the board
/HDMI/Cb4: R70.1; also elsewhere on the board
/HDMI/Cb5: R77.1; also elsewhere on the board
/HDMI/Cb6: R76.1; also elsewhere on the board
/HDMI/Cb7: R69.1; also elsewhere on the board
/HDMI/Cr0: R61.1; also elsewhere on the board
/HDMI/Cr1: R60.1; also elsewhere on the board
/HDMI/Cr2: R59.1; also elsewhere on the board
/HDMI/Cr3: R58.1; also elsewhere on the board
/HDMI/Cr4: R57.1; also elsewhere on the board
/HDMI/Cr5: R56.1; also elsewhere on the board
/HDMI/Cr6: R55.1; also elsewhere on the board
/HDMI/Cr7: R54.1; also elsewhere on the board
/HDMI/DATA_CLK: IC2.22 (IDCK); also elsewhere on the board
/HDMI/DSCL: IC2.49 (DSCL), J10.15 (SCL), R52.1, TP15.1
/HDMI/DSDA: IC2.48 (DSDA), J10.16 (SDA), R51.1, TP16.1
/HDMI/HPD: IC2.54 (HPD), J10.19 (HPD/HEAC-), R53.2
/HDMI/I2C.SCL: IC2.1 (CSCL); also elsewhere on the board
/HDMI/I2C.SDA: IC2.2 (CSDA); also elsewhere on the board
/HDMI/I2S.MCLK: IC2.38 (MCLK); also elsewhere on the board
/HDMI/I2S.SCK: IC2.45 (SCK); also elsewhere on the board
/HDMI/I2S.SD: IC2.41 (SD0); also elsewhere on the board
/HDMI/I2S.WS: IC2.44 (WS); also elsewhere on the board
/HDMI/INT: IC2.52 (INT), R73.1; also elsewhere on the board
/HDMI/IOVCC: C80.2, C81.2, C82.2, C83.2, FB3.2, IC2.3 (IOVCC_1), IC2.21 (IOVCC_2), IC2.46 (IOVCC_3)
/HDMI/RST: IC2.51 (RESET#); also elsewhere on the board
/HDMI/TX0+: IC2.62 (TX0+), J10.7 (D0+)
/HDMI/TX0-: IC2.61 (TX0-), J10.9 (D0-)
/HDMI/TX1+: IC2.65 (TX1+), J10.4 (D1+)
/HDMI/TX1-: IC2.64 (TX1-), J10.6 (D1-)
/HDMI/TX2+: IC2.68 (TX2+), J10.1 (D2+)
/HDMI/TX2-: IC2.67 (TX2-), J10.3 (D2-)
/HDMI/TXC+: IC2.59 (TXC+), J10.10 (CK+)
/HDMI/TXC-: IC2.58 (TXC-), J10.12 (CK-)
/HDMI/Y0: R75.1; also elsewhere on the board
/HDMI/Y1: R74.1; also elsewhere on the board
/HDMI/Y2: R68.1; also elsewhere on the board
/HDMI/Y3: R66.1; also elsewhere on the board
/HDMI/Y4: R65.1; also elsewhere on the board
/HDMI/Y5: R64.1; also elsewhere on the board
/HDMI/Y6: R63.1; also elsewhere on the board
/HDMI/Y7: R62.1; also elsewhere on the board
GND: C70.1, C71.1, C72.2, C73.1, C74.1, C75.1, C76.1, C77.1, C78.1, C79.2, C80.1, C81.1, C82.1, C83.1, C84.2, C85.2, C86.1, C87.1, C88.1, IC2.43 (CGND), IC2.55 (RSVDL), IC2.57 (IOGND), IC2.63 (AGND), IC2.69 (IO_SEL), IC2.70 (VDDQ), IC2.73 (EP), J10.2 (D2S), J10.5 (D1S), J10.8 (D0S), J10.11 (CKS), J10.17 (GND), R49.2, R53.1, R67.1; also elsewhere on the board
GNDPWR: C88.2, J10.SH, R67.2; also elsewhere on the board
unnamed: IC2.72 (CI2CA), R50.1
unnamed: IC2.32 (D0), R72.2
unnamed: IC2.31 (D1), R79.2
unnamed: IC2.30 (D2), R71.2
unnamed: IC2.29 (D3), R78.2
unnamed: IC2.28 (D4), R70.2
unnamed: IC2.27 (D5), R77.2
unnamed: IC2.25 (D6), R76.2
unnamed: IC2.24 (D7), R69.2
unnamed: IC2.23 (D8), R75.2
unnamed: IC2.20 (D9), R74.2
unnamed: IC2.19 (D10), R68.2
unnamed: IC2.18 (D11), R66.2
unnamed: IC2.17 (D12), R65.2
unnamed: IC2.16 (D13), R64.2
unnamed: IC2.15 (D14), R63.2
unnamed: IC2.14 (D15), R62.2
unnamed: IC2.13 (D16), R61.2
unnamed: IC2.11 (D17), R60.2
unnamed: IC2.10 (D18), R59.2
unnamed: IC2.9 (D19), R58.2
unnamed: IC2.8 (D20), R57.2
unnamed: IC2.7 (D21), R56.2
unnamed: IC2.6 (D22), R55.2
unnamed: IC2.4 (D23), R54.2
unnamed: IC2.56 (EXT_SWING), R49.1

Notes on the sheet:
1.2V CVCC
HDMI 1.4a Transmitter
1.2V AVCC
HDMI 1.4 Connector
3V3 IOVCC

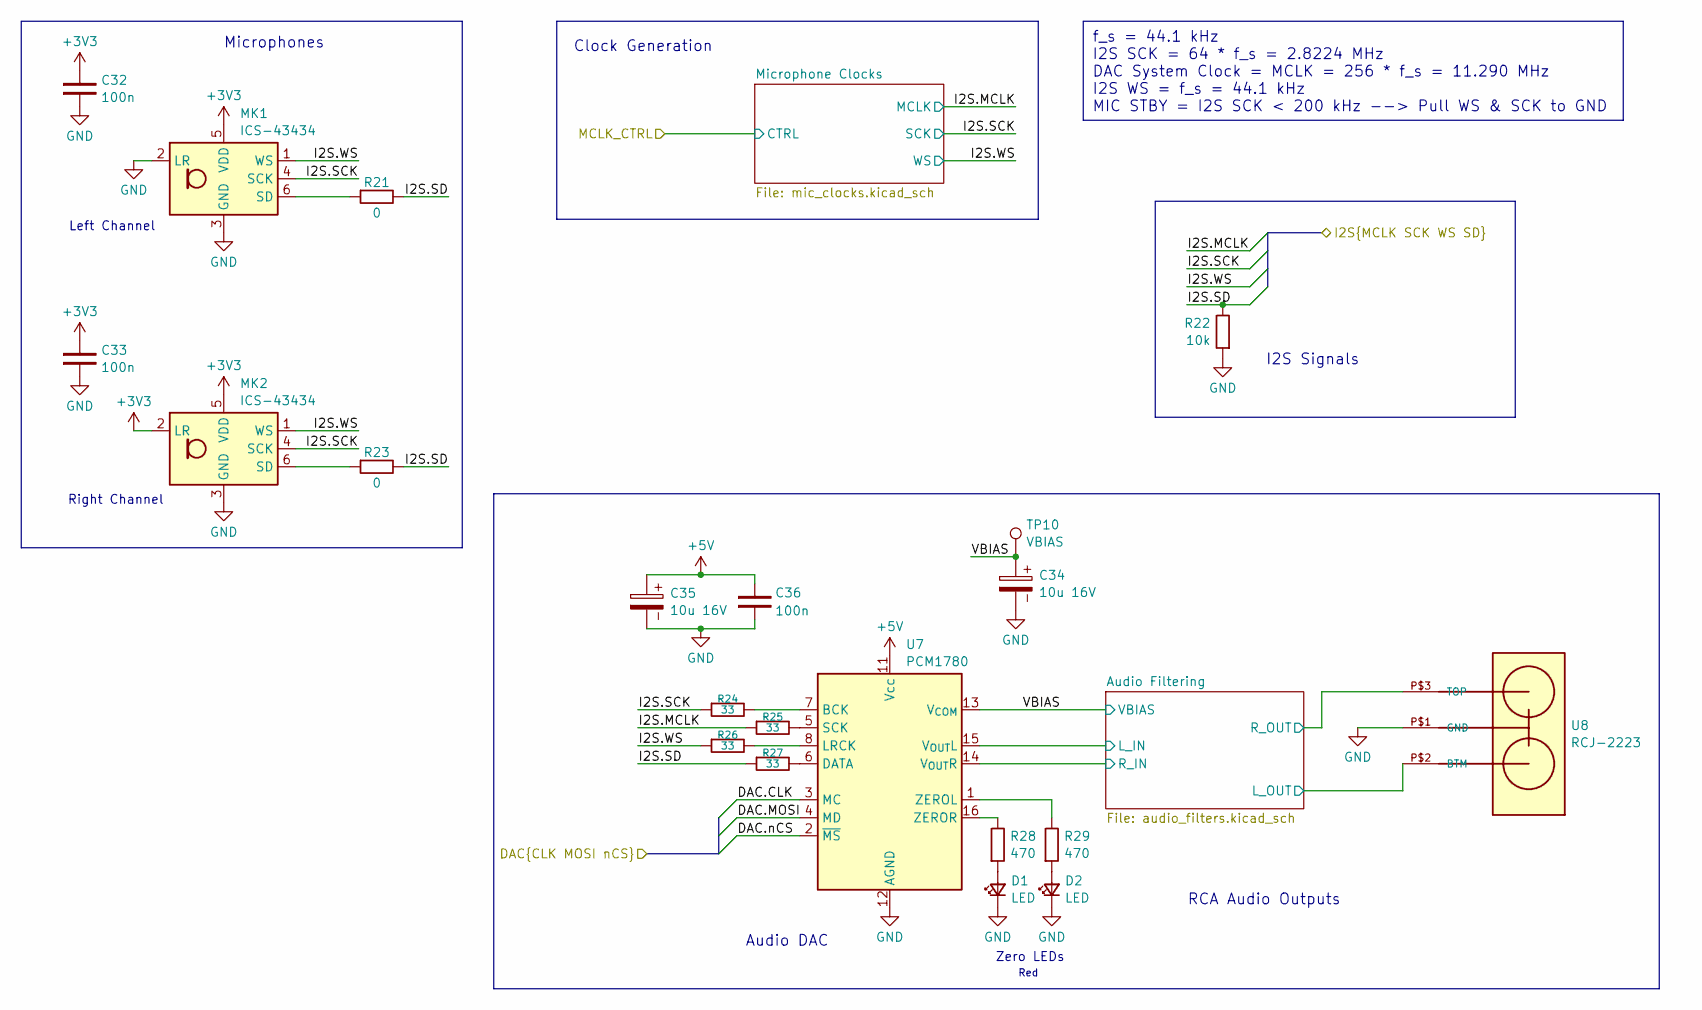
[picture p10: schematic microphone_interface.kicad_sch, Camera Testing Board]

Parts:
C32, C33, C36: 100n; C_0603_1608Metric
C34, C35: 10u 16V; CP_EIA-3216-18_Kemet-A
D1, D2: LED; LED_0603_1608Metric
MK1, MK2: ICS-43434; InvenSense_ICS-43434-6_3.5x2.65mm
R21, R23: 0; R_0603_1608Metric
R22: 10k; R_0603_1608Metric
R24, R25, R26, R27: 33; R_0402_1005Metric
R28, R29: 470; R_0603_1608Metric
TP10: VBIAS; TestPoint_Keystone_5000-5004_Miniature
U7: PCM1780; SSOP-16_3.9x4.9mm_P0.635mm
U8: RCJ-2223; DUALRCA

Connections:
+3V3: C32.2, C33.2, MK1.5 (VDD), MK2.2 (LR), MK2.5 (VDD); also elsewhere on the board
+5V: C35.1, C36.2, U7.11 (Vcc); also elsewhere on the board
/HDMI/I2S.MCLK: R25.1; also elsewhere on the board
/HDMI/I2S.SCK: MK1.4 (SCK), MK2.4 (SCK), R24.1; also elsewhere on the board
/HDMI/I2S.SD: R21.2, R22.2, R23.2, R27.1; also elsewhere on the board
/HDMI/I2S.WS: MK1.1 (WS), MK2.1 (WS), R26.1; also elsewhere on the board
/Microcontroller/DAC.CLK: U7.3 (MC); also elsewhere on the board
/Microcontroller/DAC.MOSI: U7.4 (MD); also elsewhere on the board
/Microcontroller/DAC.nCS: U7.2 (~MS); also elsewhere on the board
/Microphone Interface/Audio Filtering/L_IN: U7.15 (V_{OUT}L); also elsewhere on the board
/Microphone Interface/Audio Filtering/L_OUT: U8.P$2 (BTM); also elsewhere on the board
/Microphone Interface/Audio Filtering/R_IN: U7.14 (V_{OUT}R); also elsewhere on the board
/Microphone Interface/Audio Filtering/R_OUT: U8.P$3 (TOP); also elsewhere on the board
/Microphone Interface/VBIAS: C34.1, TP10.1, U7.13 (V_{COM}); also elsewhere on the board
GND: C32.1, C33.1, C34.2, C35.2, C36.1, D1.1 (K), D2.1 (K), MK1.2 (LR), MK1.3 (GND), MK2.3 (GND), R22.1, U7.12 (AGND), U8.P$1 (GND); also elsewhere on the board
unnamed: D1.2 (A), R28.1
unnamed: D2.2 (A), R29.1
unnamed: MK1.6 (SD), R21.1
unnamed: MK2.6 (SD), R23.1
unnamed: R24.2, U7.7 (BCK)
unnamed: R27.2, U7.6 (DATA)
unnamed: R26.2, U7.8 (LRCK)
unnamed: R25.2, U7.5 (SCK)
unnamed: R29.2, U7.1 (ZEROL)
unnamed: R28.2, U7.16 (ZEROR)

Notes on the sheet:
f_s = 44.1 kHz I2S SCK = 64 * f_s = 2.8224 MHz DAC System Clock = MCLK = 256 * f_s = 11.290 MHz I2S WS = f_s = 44.1 kHz MIC STBY = I2S SCK < 200 kHz --> Pull WS & SCK to GND
Right Channel
Left Channel
Audio DAC
Red
I2S Signals
Microphones
RCA Audio Outputs
Clock Generation
Zero LEDs

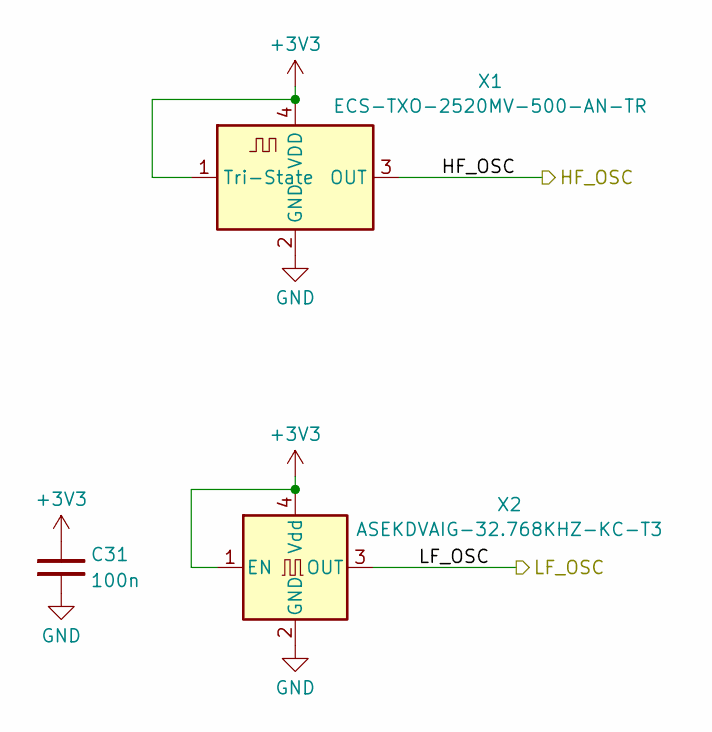
[picture p11: schematic MCU_OSC.kicad_sch, Camera Testing Board]

Parts:
C31: 100n; C_0603_1608Metric
X1: ECS-TXO-2520MV-500-AN-TR; Oscillator_SMD_ECS_2520MV-xxx-xx-4Pin_2.5x2.0mm
X2: ASEKDVAIG-32.768KHZ-KC-T3; Oscillator_SMD_Abracon_ASE-4Pin_3.2x2.5mm

Connections:
+3V3: C31.2, X1.1 (Tri-State), X1.4 (VDD), X2.1 (EN), X2.4 (Vdd); also elsewhere on the board
/Microcontroller/32.768kHz_OSC: X2.3 (OUT); also elsewhere on the board
/Microcontroller/50MHz_OSC: X1.3 (OUT); also elsewhere on the board
GND: C31.1, X1.2 (GND), X2.2 (GND); also elsewhere on the board

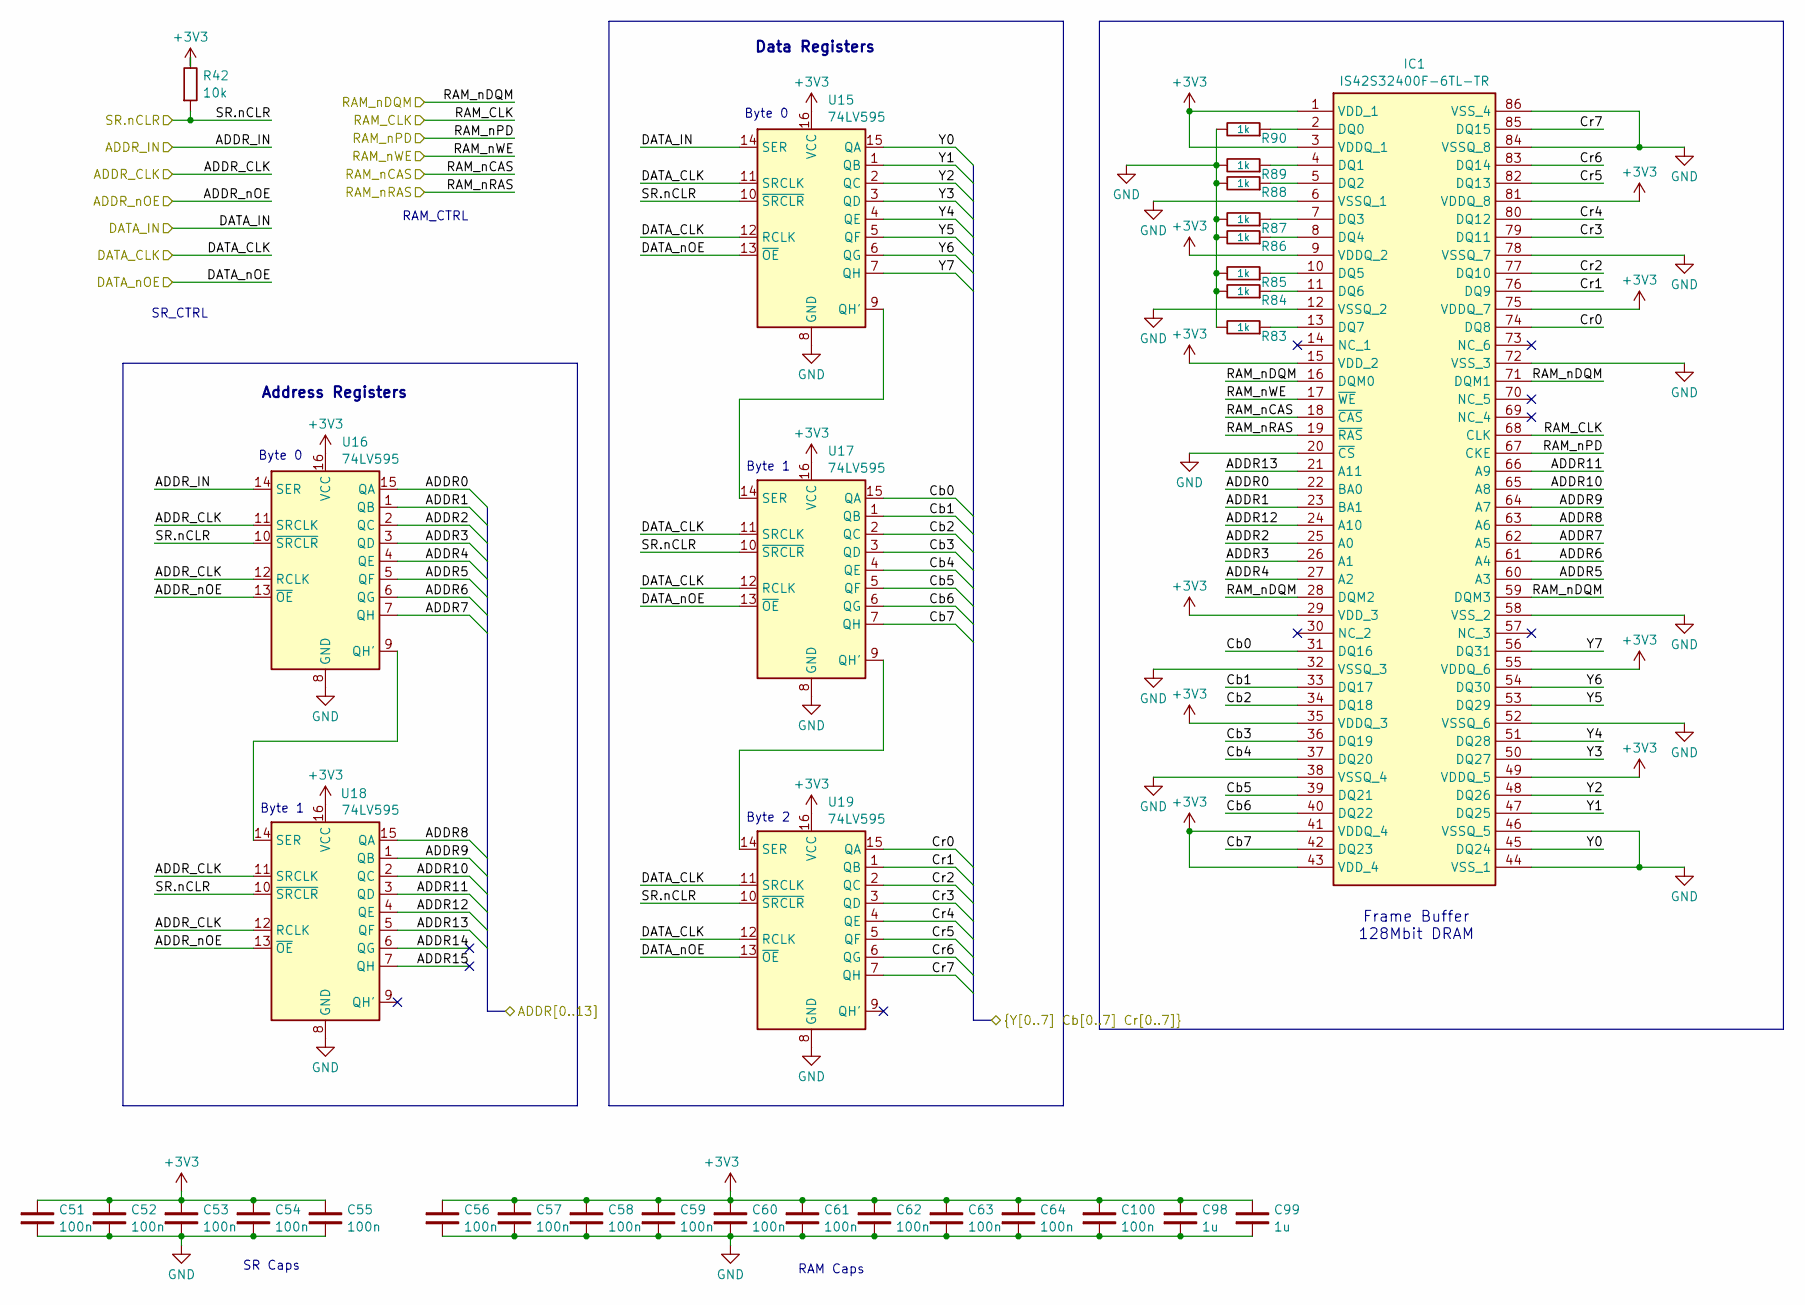
[picture p12: schematic frame_buffer.kicad_sch, Camera Testing Board]

Parts:
C51, C52, C53, C54, C55: 100n; C_0603_1608Metric
C56, C57, C58, C59, C60, C61, C62, C63, C64, C100: 100n; C_0402_1005Metric
C98, C99: 1u; C_0603_1608Metric
IC1: IS42S32400F-6TL-TR; SOP50P1176X120-86N; Mouser Part Number 870-IS42S32400F6TLTR
R42: 10k; R_0603_1608Metric
R83, R84, R85, R86, R87, R88, R89, R90: 1k; R_0402_1005Metric
U15, U16, U17, U18, U19: 74LV595; SOIC-16_3.9x9.9mm_P1.27mm

Connections:
+3V3: C51.2, C52.2, C53.2, C54.2, C55.2, C56.2, C57.2, C58.2, C59.2, C60.2, C61.2, C62.2, C63.2, C64.2, C98.2, C99.2, C100.2, IC1.1 (VDD_1), IC1.3 (VDDQ_1), IC1.9 (VDDQ_2), IC1.15 (VDD_2), IC1.29 (VDD_3), IC1.35 (VDDQ_3), IC1.41 (VDDQ_4), IC1.43 (VDD_4), IC1.49 (VDDQ_5), IC1.55 (VDDQ_6), IC1.75 (VDDQ_7), IC1.81 (VDDQ_8), R42.2, U15.16 (VCC), U16.16 (VCC), U17.16 (VCC), U18.16 (VCC), U19.16 (VCC); also elsewhere on the board
/HDMI/Cb0: IC1.31 (DQ16), U17.15 (QA); also elsewhere on the board
/HDMI/Cb1: IC1.33 (DQ17), U17.1 (QB); also elsewhere on the board
/HDMI/Cb2: IC1.34 (DQ18), U17.2 (QC); also elsewhere on the board
/HDMI/Cb3: IC1.36 (DQ19), U17.3 (QD); also elsewhere on the board
/HDMI/Cb4: IC1.37 (DQ20), U17.4 (QE); also elsewhere on the board
/HDMI/Cb5: IC1.39 (DQ21), U17.5 (QF); also elsewhere on the board
/HDMI/Cb6: IC1.40 (DQ22), U17.6 (QG); also elsewhere on the board
/HDMI/Cb7: IC1.42 (DQ23), U17.7 (QH); also elsewhere on the board
/HDMI/Cr0: IC1.74 (DQ8), U19.15 (QA); also elsewhere on the board
/HDMI/Cr1: IC1.76 (DQ9), U19.1 (QB); also elsewhere on the board
/HDMI/Cr2: IC1.77 (DQ10), U19.2 (QC); also elsewhere on the board
/HDMI/Cr3: IC1.79 (DQ11), U19.3 (QD); also elsewhere on the board
/HDMI/Cr4: IC1.80 (DQ12), U19.4 (QE); also elsewhere on the board
/HDMI/Cr5: IC1.82 (DQ13), U19.5 (QF); also elsewhere on the board
/HDMI/Cr6: IC1.83 (DQ14), U19.6 (QG); also elsewhere on the board
/HDMI/Cr7: IC1.85 (DQ15), U19.7 (QH); also elsewhere on the board
/HDMI/Y0: IC1.45 (DQ24), U15.15 (QA); also elsewhere on the board
/HDMI/Y1: IC1.47 (DQ25), U15.1 (QB); also elsewhere on the board
/HDMI/Y2: IC1.48 (DQ26), U15.2 (QC); also elsewhere on the board
/HDMI/Y3: IC1.50 (DQ27), U15.3 (QD); also elsewhere on the board
/HDMI/Y4: IC1.51 (DQ28), U15.4 (QE); also elsewhere on the board
/HDMI/Y5: IC1.53 (DQ29), U15.5 (QF); also elsewhere on the board
/HDMI/Y6: IC1.54 (DQ30), U15.6 (QG); also elsewhere on the board
/HDMI/Y7: IC1.56 (DQ31), U15.7 (QH); also elsewhere on the board
/Memory/A.CLK: U16.11 (SRCLK), U16.12 (RCLK), U18.11 (SRCLK), U18.12 (RCLK); also elsewhere on the board
/Memory/A.IN: U16.14 (SER); also elsewhere on the board
/Memory/A.nOE: U16.13 (~OE), U18.13 (~OE); also elsewhere on the board
/Memory/ADDR0: IC1.22 (BA0), U16.15 (QA)
/Memory/ADDR1: IC1.23 (BA1), U16.1 (QB)
/Memory/ADDR2: IC1.25 (A0), U16.2 (QC)
/Memory/ADDR3: IC1.26 (A1), U16.3 (QD)
/Memory/ADDR4: IC1.27 (A2), U16.4 (QE)
/Memory/ADDR5: IC1.60 (A3), U16.5 (QF)
/Memory/ADDR6: IC1.61 (A4), U16.6 (QG)
/Memory/ADDR7: IC1.62 (A5), U16.7 (QH)
/Memory/ADDR8: IC1.63 (A6), U18.15 (QA)
/Memory/ADDR9: IC1.64 (A7), U18.1 (QB)
/Memory/ADDR10: IC1.65 (A8), U18.2 (QC)
/Memory/ADDR11: IC1.66 (A9), U18.3 (QD)
/Memory/ADDR12: IC1.24 (A10), U18.4 (QE)
/Memory/ADDR13: IC1.21 (A11), U18.5 (QF)
/Memory/D.CLK: U15.11 (SRCLK), U15.12 (RCLK), U17.11 (SRCLK), U17.12 (RCLK), U19.11 (SRCLK), U19.12 (RCLK); also elsewhere on the board
/Memory/D.IN: U15.14 (SER); also elsewhere on the board
/Memory/D.nOE: U15.13 (~OE), U17.13 (~OE), U19.13 (~OE); also elsewhere on the board
/Memory/Frame Buffer/ADDR14: U18.6 (QG)
/Memory/Frame Buffer/ADDR15: U18.7 (QH)
/Memory/RAM.CLK: IC1.68 (CLK); also elsewhere on the board
/Memory/RAM.nCAS: IC1.18 (~CAS); also elsewhere on the board
/Memory/RAM.nDQM: IC1.16 (DQM0), IC1.28 (DQM2), IC1.59 (DQM3), IC1.71 (DQM1); also elsewhere on the board
/Memory/RAM.nPD: IC1.67 (CKE); also elsewhere on the board
/Memory/RAM.nRAS: IC1.19 (~RAS); also elsewhere on the board
/Memory/RAM.nWE: IC1.17 (~WE); also elsewhere on the board
/Memory/SR.nCLR: R42.1, U15.10 (~SRCLR), U16.10 (~SRCLR), U17.10 (~SRCLR), U18.10 (~SRCLR), U19.10 (~SRCLR); also elsewhere on the board
GND: C51.1, C52.1, C53.1, C54.1, C55.1, C56.1, C57.1, C58.1, C59.1, C60.1, C61.1, C62.1, C63.1, C64.1, C98.1, C99.1, C100.1, IC1.6 (VSSQ_1), IC1.12 (VSSQ_2), IC1.20 (~CS), IC1.32 (VSSQ_3), IC1.38 (VSSQ_4), IC1.44 (VSS_1), IC1.46 (VSSQ_5), IC1.52 (VSSQ_6), IC1.58 (VSS_2), IC1.72 (VSS_3), IC1.78 (VSSQ_7), IC1.84 (VSSQ_8), IC1.86 (VSS_4), R83.2, R84.2, R85.2, R86.2, R87.2, R88.2, R89.2, R90.2, U15.8 (GND), U16.8 (GND), U17.8 (GND), U18.8 (GND), U19.8 (GND); also elsewhere on the board
unnamed: IC1.2 (DQ0), R90.1
unnamed: IC1.4 (DQ1), R89.1
unnamed: IC1.5 (DQ2), R88.1
unnamed: IC1.7 (DQ3), R87.1
unnamed: IC1.8 (DQ4), R86.1
unnamed: IC1.10 (DQ5), R85.1
unnamed: IC1.11 (DQ6), R84.1
unnamed: IC1.13 (DQ7), R83.1
unnamed: U15.9 (QH'), U17.14 (SER)
unnamed: U16.9 (QH'), U18.14 (SER)
unnamed: U17.9 (QH'), U19.14 (SER)

Notes on the sheet:
SR_CTRL
Byte 0
Byte 1
Byte 2
RAM Caps
SR Caps
Address Registers
Frame Buffer 128Mbit DRAM
RAM_CTRL
Data Registers

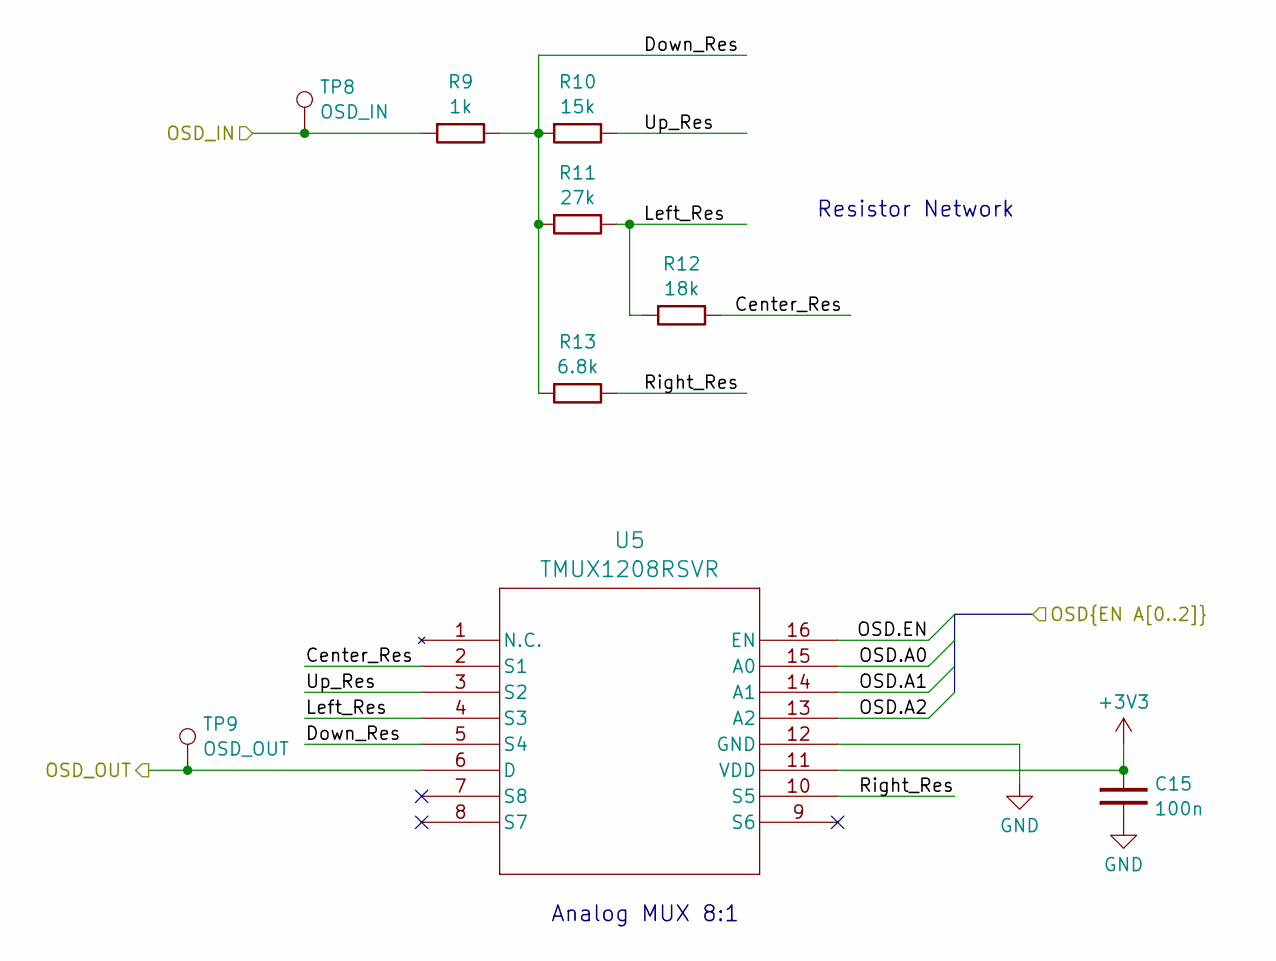
[picture p13: schematic osd_ctrl.kicad_sch, Camera Testing Board]

Parts:
C15: 100n; C_0603_1608Metric
R9: 1k; R_0603_1608Metric
R10: 15k; R_0603_1608Metric
R11: 27k; R_0603_1608Metric
R12: 18k; R_0603_1608Metric
R13: 6.8k; R_0603_1608Metric
TP8: OSD_IN; TestPoint_Keystone_5000-5004_Miniature
TP9: OSD_OUT; TestPoint_Keystone_5000-5004_Miniature
U5: TMUX1208RSVR; RSV16_TEX

Connections:
+3V3: C15.2, U5.11 (VDD); also elsewhere on the board
/Camera Interface/OSD CTRL/Center_Res: R12.2, U5.2 (S1)
/Camera Interface/OSD CTRL/Down_Res: R9.2, R10.1, R11.1, R13.1, U5.5 (S4)
/Camera Interface/OSD CTRL/Left_Res: R11.2, R12.1, U5.4 (S3)
/Camera Interface/OSD CTRL/OSD_IN: R9.1, TP8.1; also elsewhere on the board
/Camera Interface/OSD CTRL/OSD_OUT: TP9.1, U5.6 (D); also elsewhere on the board
/Camera Interface/OSD CTRL/Right_Res: R13.2, U5.10 (S5)
/Camera Interface/OSD CTRL/Up_Res: R10.2, U5.3 (S2)
/Camera Interface/OSD.A0: U5.15 (A0); also elsewhere on the board
/Camera Interface/OSD.A1: U5.14 (A1); also elsewhere on the board
/Camera Interface/OSD.A2: U5.13 (A2); also elsewhere on the board
/Camera Interface/OSD.EN: U5.16 (EN); also elsewhere on the board
GND: C15.1, U5.12 (GND); also elsewhere on the board

Notes on the sheet:
Resistor Network
Analog MUX 8:1

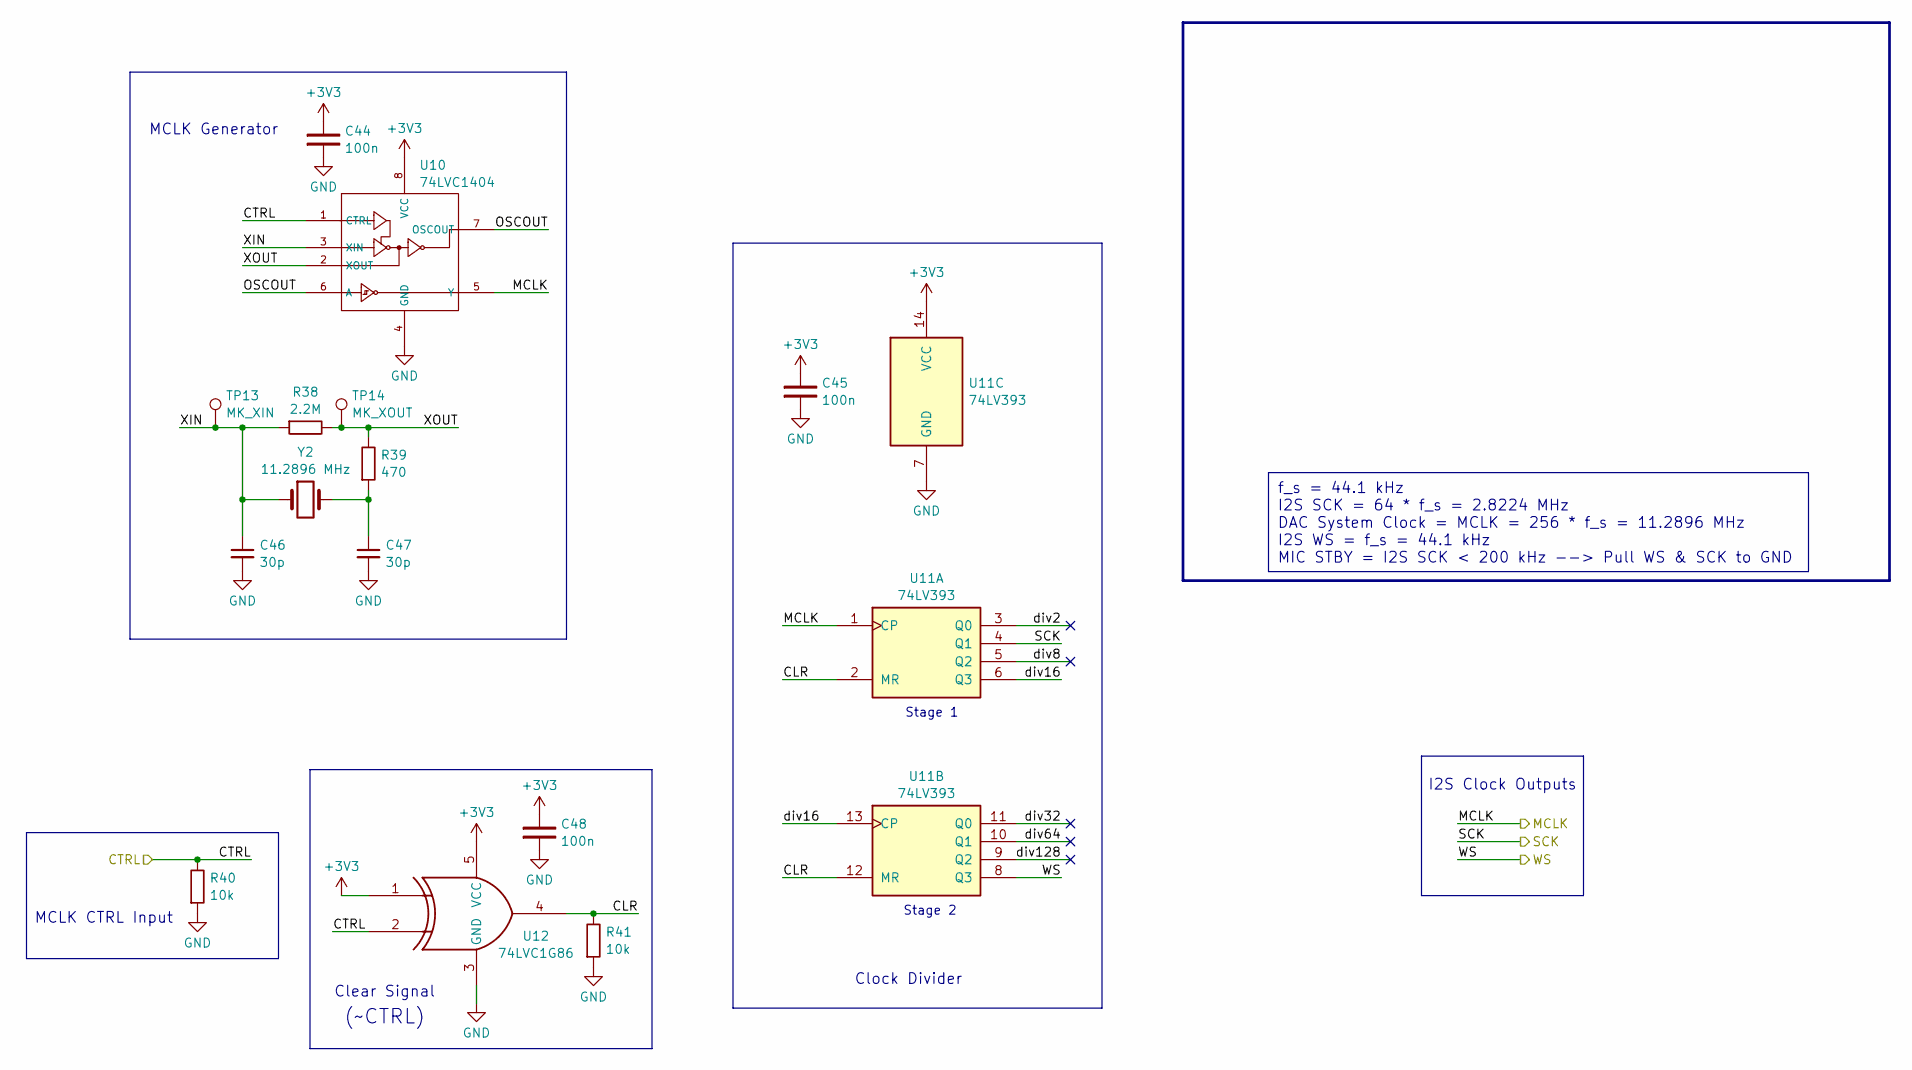
[picture p14: schematic mic_clocks.kicad_sch, Camera Testing Board]

Parts:
C44, C45, C48: 100n; C_0603_1608Metric
C46, C47: 30p; C_0402_1005Metric
R38: 2.2M; R_0603_1608Metric
R39: 470; R_0603_1608Metric
R40, R41: 10k; R_0603_1608Metric
TP13: MK_XIN; TestPoint_Keystone_5000-5004_Miniature
TP14: MK_XOUT; TestPoint_Keystone_5000-5004_Miniature
U10: 74LVC1404; SSOP-8_2.95x2.8mm_P0.65mm
U11: 74LV393; SOIC-14_3.9x8.7mm_P1.27mm
U12: 74LVC1G86; SOT-353_SC-70-5
Y2: 11.2896 MHz; Crystal_SMD_Abracon_ABM3-2Pin_5.0x3.2mm

Connections:
+3V3: C44.2, C45.2, C48.2, U10.8 (VCC), U11.14 (VCC), U12.1, U12.5 (VCC); also elsewhere on the board
/HDMI/I2S.MCLK: U10.5 (Y), U11.1 (CP); also elsewhere on the board
/HDMI/I2S.SCK: U11.4 (Q1); also elsewhere on the board
/HDMI/I2S.WS: U11.8 (Q3); also elsewhere on the board
/Microphone Interface/Microphone Clocks/CLR: R41.2, U11.2 (MR), U11.12 (MR), U12.4
/Microphone Interface/Microphone Clocks/CTRL: R40.2, U10.1 (CTRL), U12.2; also elsewhere on the board
/Microphone Interface/Microphone Clocks/OSCOUT: U10.6 (A), U10.7 (OSCOUT)
/Microphone Interface/Microphone Clocks/XIN: C46.1, R38.1, TP13.1, U10.3 (XIN), Y2.1
/Microphone Interface/Microphone Clocks/XOUT: R38.2, R39.2, TP14.1, U10.2 (XOUT)
/Microphone Interface/Microphone Clocks/div2: U11.3 (Q0)
/Microphone Interface/Microphone Clocks/div8: U11.5 (Q2)
/Microphone Interface/Microphone Clocks/div16: U11.6 (Q3), U11.13 (CP)
/Microphone Interface/Microphone Clocks/div32: U11.11 (Q0)
/Microphone Interface/Microphone Clocks/div64: U11.10 (Q1)
/Microphone Interface/Microphone Clocks/div128: U11.9 (Q2)
GND: C44.1, C45.1, C46.2, C47.2, C48.1, R40.1, R41.1, U10.4 (GND), U11.7 (GND), U12.3 (GND); also elsewhere on the board
unnamed: C47.1, R39.1, Y2.2

Notes on the sheet:
f_s = 44.1 kHz I2S SCK = 64 * f_s = 2.8224 MHz DAC System Clock = MCLK = 256 * f_s = 11.2896 MHz I2S WS = f_s = 44.1 kHz MIC STBY = I2S SCK < 200 kHz --> Pull WS & SCK to GND
Clear Signal
Stage 2
I2S Clock Outputs
Clock Divider
Stage 1
(~CTRL)
MCLK CTRL Input
MCLK Generator

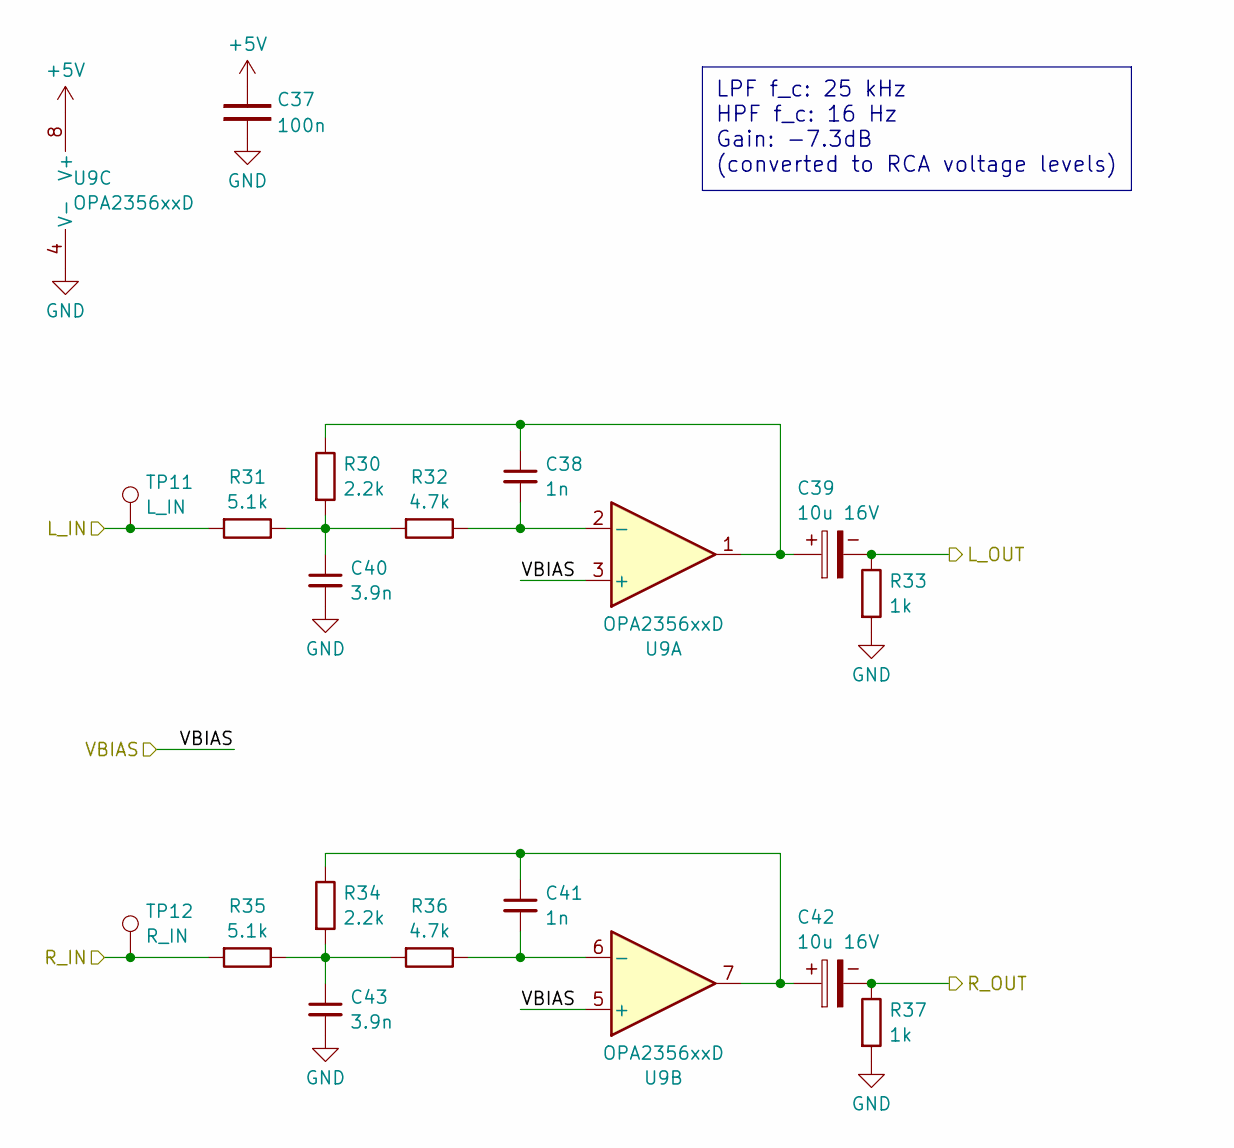
[picture p15: schematic audio_filters.kicad_sch, Camera Testing Board]

Parts:
C37: 100n; C_0603_1608Metric
C38, C41: 1n; C_0603_1608Metric
C39, C42: 10u 16V; CP_EIA-3216-18_Kemet-A
C40, C43: 3.9n; C_0603_1608Metric
R30, R34: 2.2k; R_0603_1608Metric
R31, R35: 5.1k; R_0603_1608Metric
R32, R36: 4.7k; R_0603_1608Metric
R33, R37: 1k; R_0603_1608Metric
TP11: L_IN; TestPoint_Keystone_5000-5004_Miniature
TP12: R_IN; TestPoint_Keystone_5000-5004_Miniature
U9: OPA2356xxD; SOIC-8_3.9x4.9mm_P1.27mm

Connections:
+5V: C37.2, U9.8 (V+); also elsewhere on the board
/Microphone Interface/Audio Filtering/L_IN: R31.1, TP11.1; also elsewhere on the board
/Microphone Interface/Audio Filtering/L_OUT: C39.2, R33.2; also elsewhere on the board
/Microphone Interface/Audio Filtering/R_IN: R35.1, TP12.1; also elsewhere on the board
/Microphone Interface/Audio Filtering/R_OUT: C42.2, R37.2; also elsewhere on the board
/Microphone Interface/VBIAS: U9.3 (+), U9.5 (+); also elsewhere on the board
GND: C37.1, C40.2, C43.2, R33.1, R37.1, U9.4 (V-); also elsewhere on the board
unnamed: C38.1, C39.1, R30.2, U9.1
unnamed: C40.1, R30.1, R31.2, R32.1
unnamed: C41.1, C42.1, R34.2, U9.7
unnamed: C43.1, R34.1, R35.2, R36.1
unnamed: C38.2, R32.2, U9.2 (-)
unnamed: C41.2, R36.2, U9.6 (-)

Notes on the sheet:
LPF f_c: 25 kHz HPF f_c: 16 Hz Gain: -7.3dB (converted to RCA voltage levels)
