evaneidt/Camera-Dev/Schematics/Camera/Camera.kicad_pcb

## KiCad design Schematics/Camera/Camera.kicad_pcb (continued)

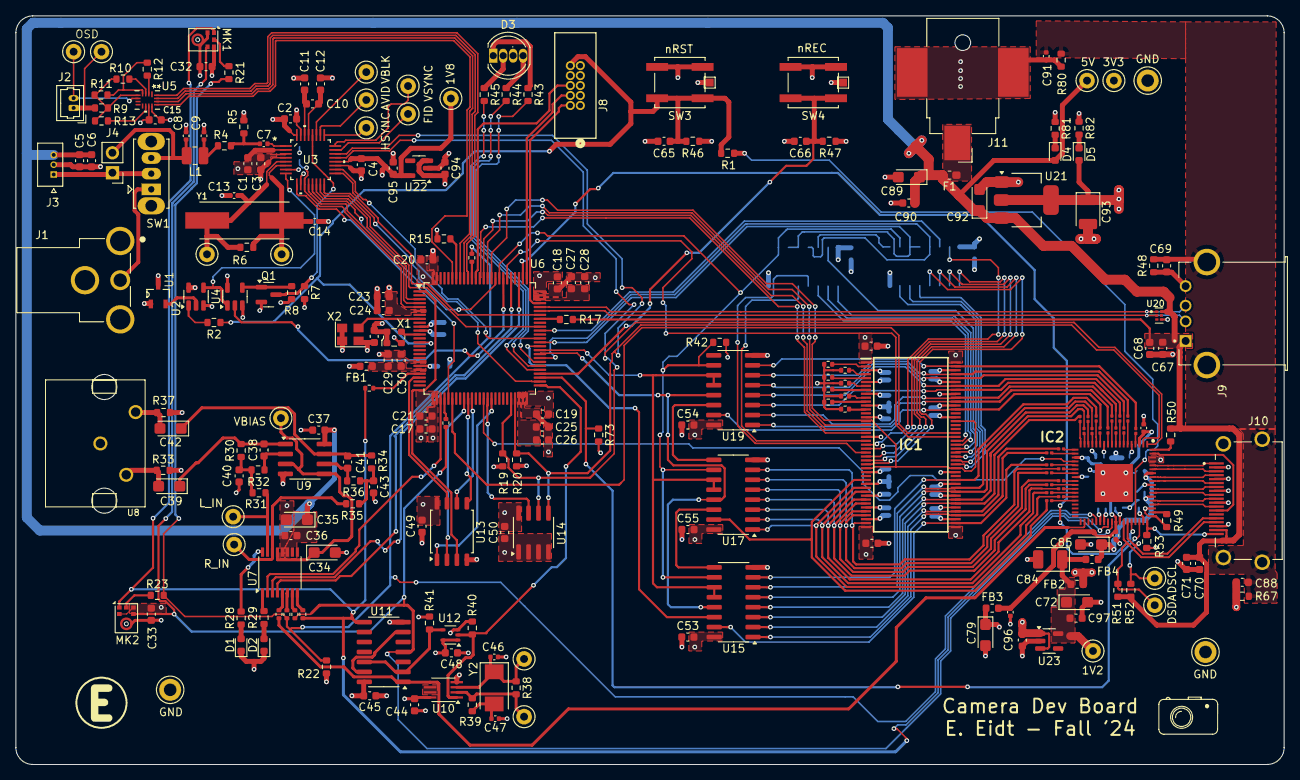
[picture p16: board Camera.kicad_pcb from above]

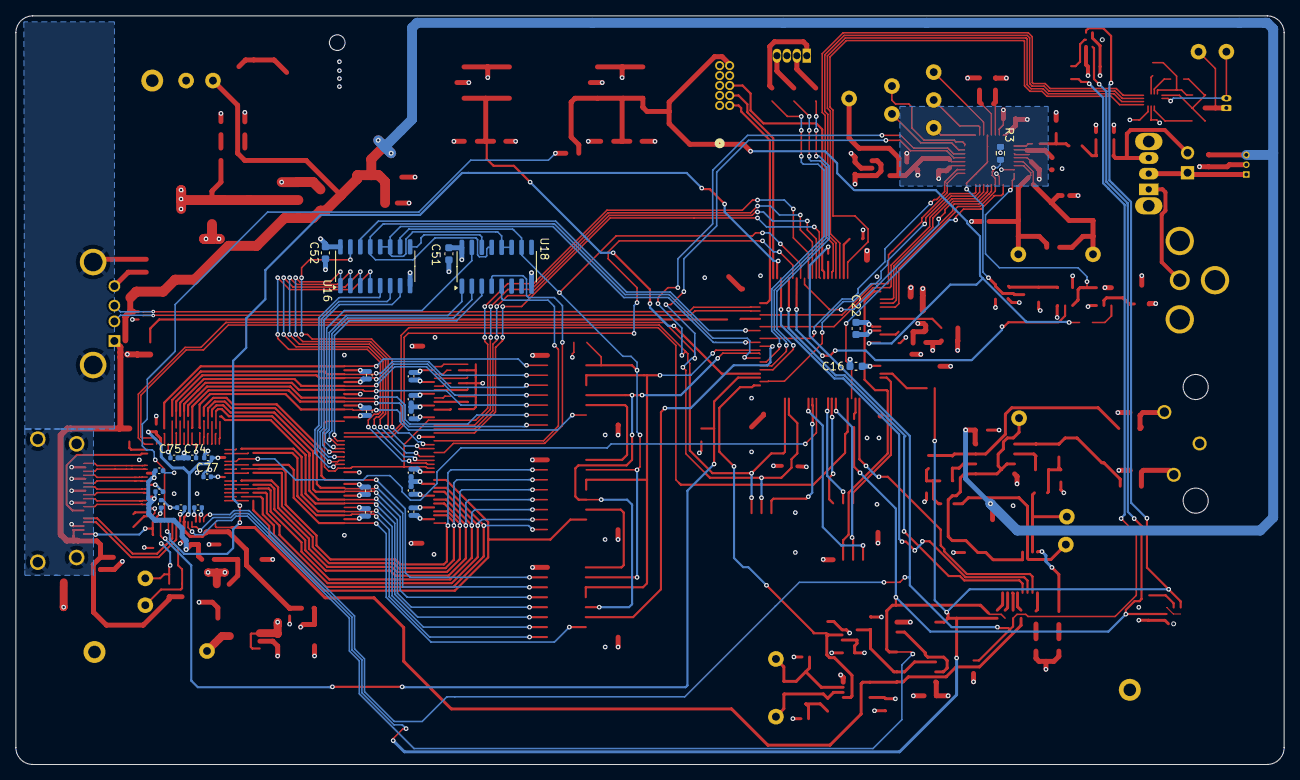
[picture p17: board Camera.kicad_pcb from below]

Board: 4 copper layers, 161.8 x 95.5 mm, 269 parts (26 on the bottom side), 226 nets.

Other parts of the board:
PAD1, PAD2: TestPoint_Pad_1.0x1.0mm
