evaneidt/Camera-Dev/(commit log)

2024-11-17 Pushing Kicad and code
    [Camera.kicad_pcb, Camera.kicad_sch, Camera_BOM.csv, Display.kicad_sch, MCU.kicad_sch, MCU_OSC.kicad_sch, Power.kicad_sch, audio_filters.kicad_sch]
2024-11-18 Working on init section of camera board firmware
2025-02-08 Pushing to share current version
